lutetjeff/ece395/README.md

Repository for UIUC ECE395 project known as RHipoff. A mixture of the Rhythm Horizon and RE:Flex Dance platforms built from the ground up.
Current configuration is for four load cells only, but firmware supports up to 16 different panels with four load cells each.
