lutetjeff/ece395/exercises/ex4/outputs/3d-back.png

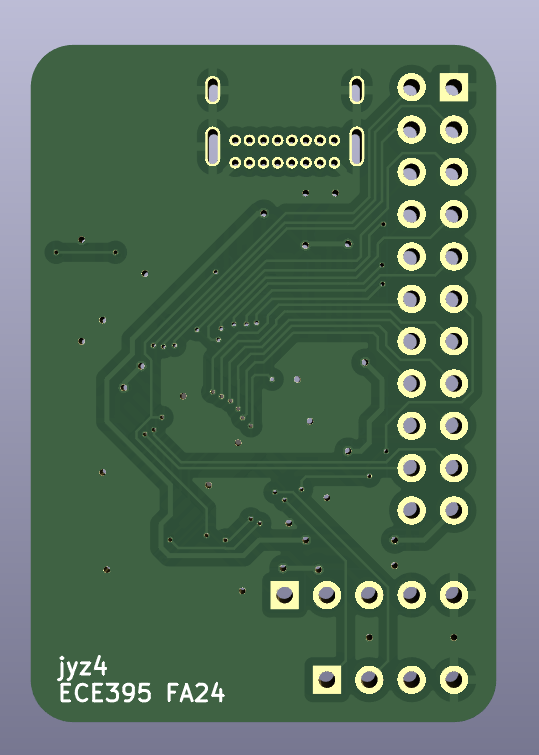
exercises/ex4/outputs/3d-back.png
