lutetjeff/ece395/exercises/ex4/outputs/3d-front.png

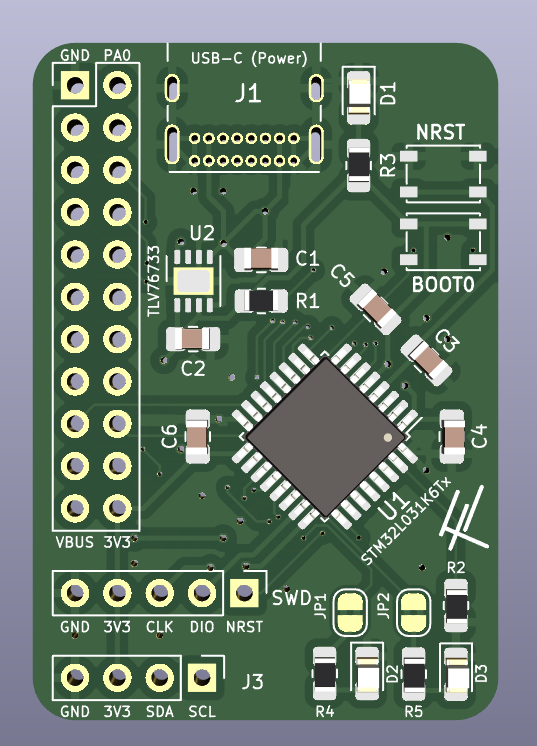
exercises/ex4/outputs/3d-front.png
