lutetjeff/ece395/exercises/ex4/outputs/2024-09-12_16-09.png

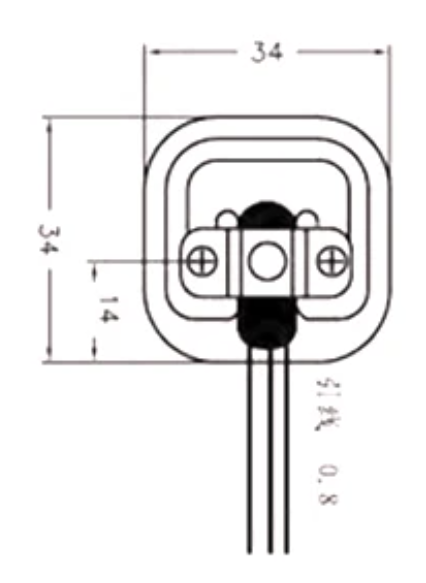
exercises/ex4/outputs/2024-09-12_16-09.png
