lutetjeff/ece395/exercises/ex4/outputs/layout_screenshot.png

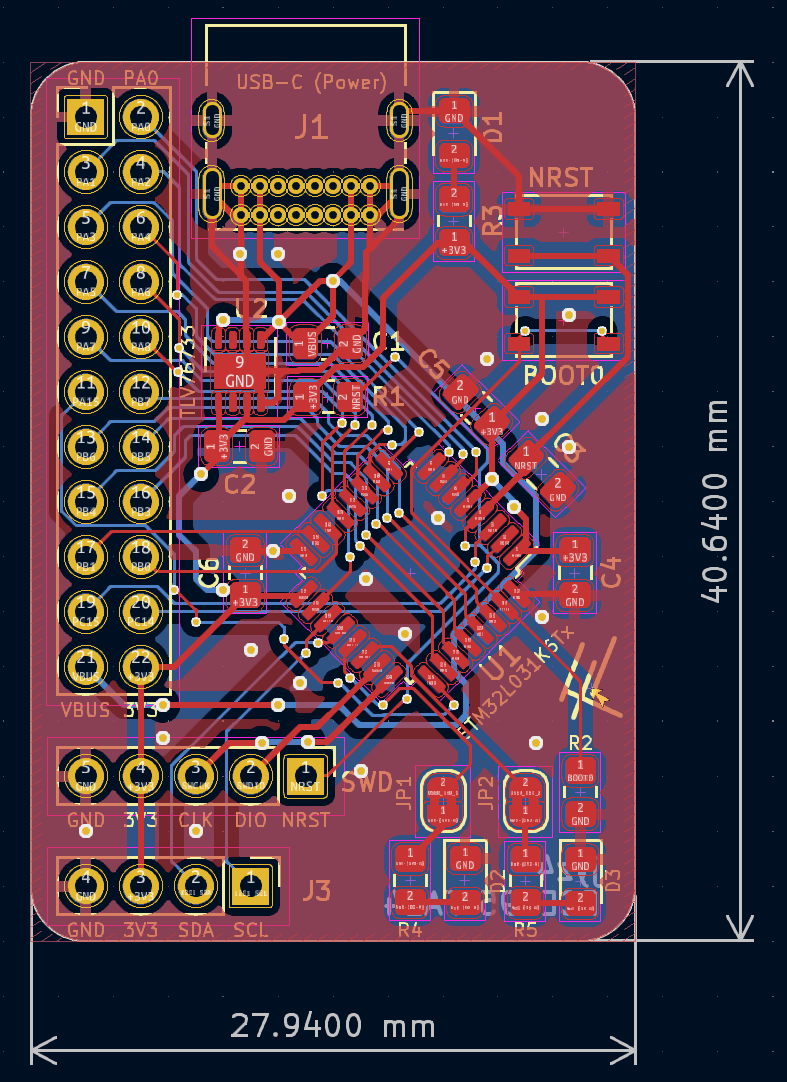
exercises/ex4/outputs/layout_screenshot.png
