lutetjeff/ece395/(list of files, cad)

Other CAD files:
CADFiles/Generic Single Pad Assembly v8.f3z
CADFiles/Load Cell Mount v8.f3z
CADFiles/Plunger v1.f3d
CADFiles/Polycarbonate Top v1.f3d
CADFiles/SparkFun Generic Load Cell v1.f3d
CADFiles/Wooden Base v4.f3d
