lutetjeff/ece395/exercises/ex4/outputs/ex4-F_Silkscreen.pdf

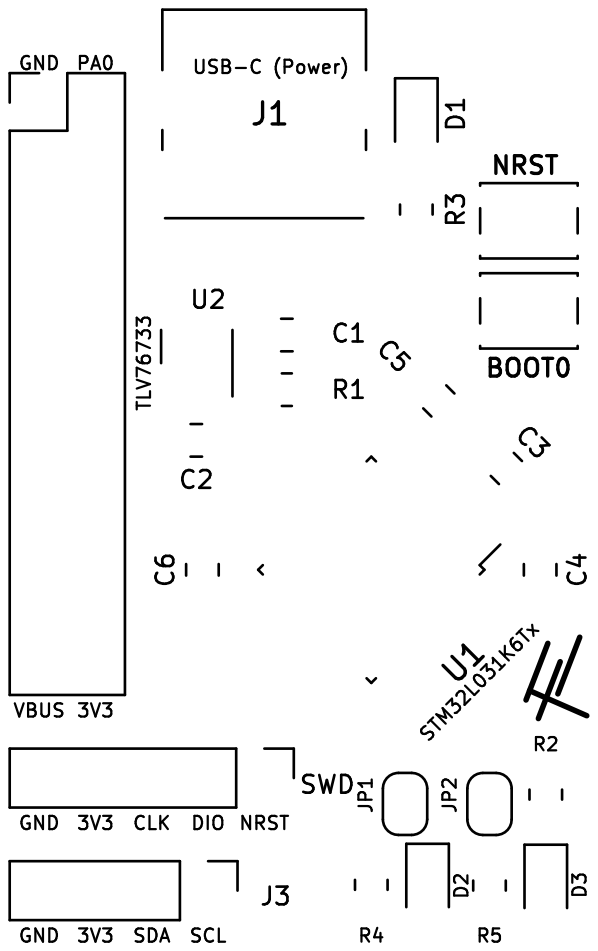
[picture p5: page 1]

GND 3V3 CLK DIO NRST GND 3V3 SDA SCL USB-C (Power) TLV76733
