lutetjeff/ece395/exercises/ex4/outputs/ex4.pdf

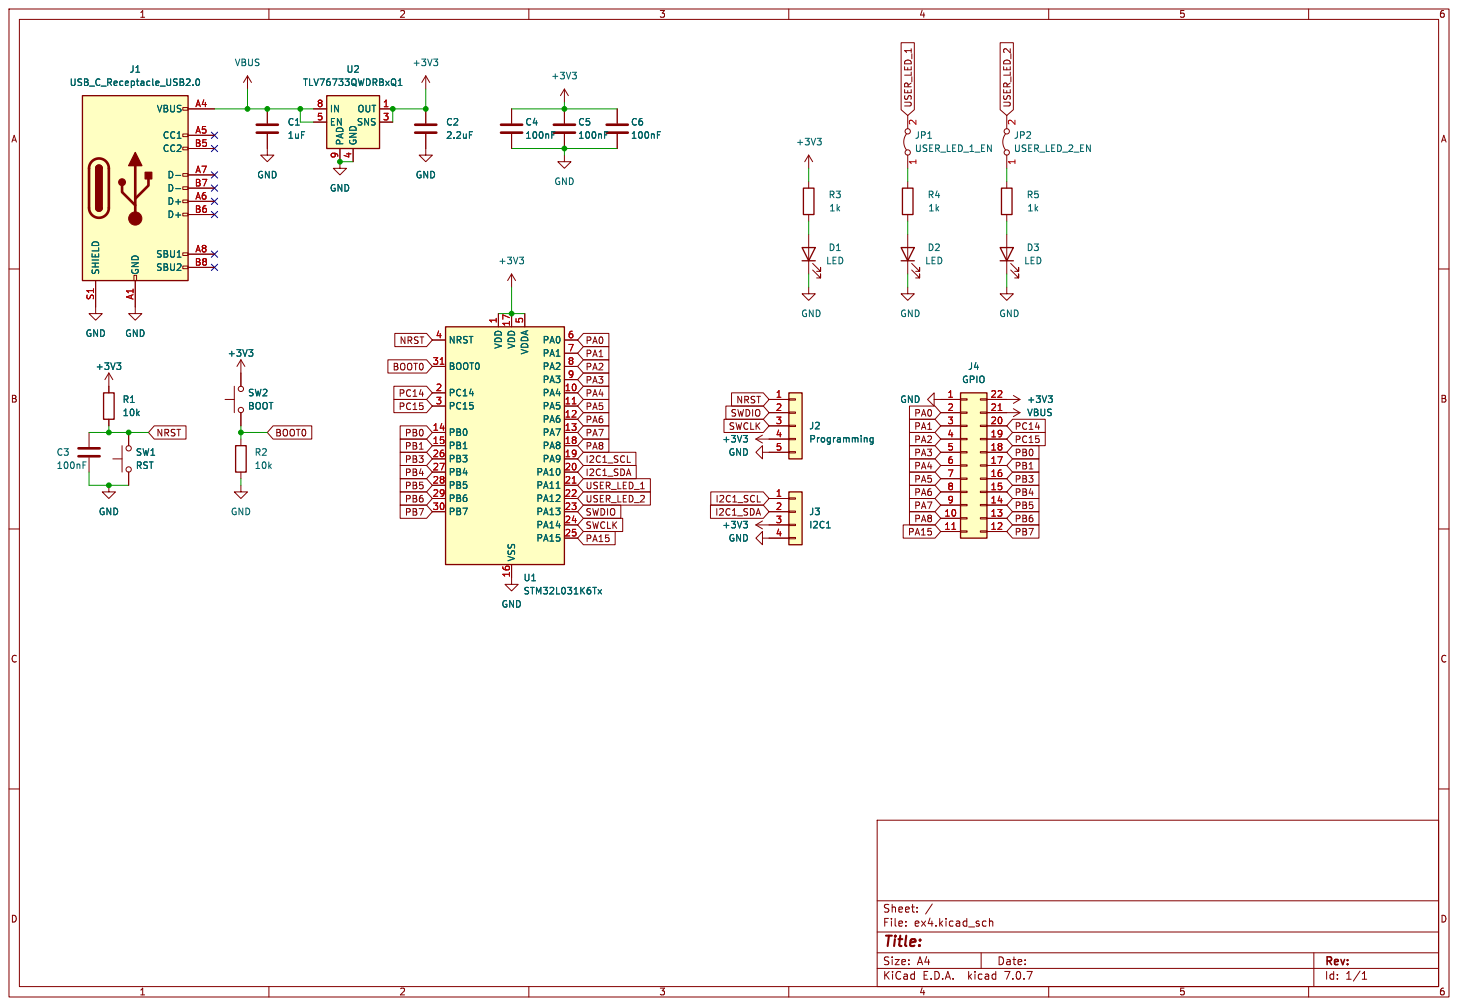
[picture p6: page 1]

1 PA4 10 PA5 11 PA6 12 PA7 13 PB0 14 PB1 15 VSS 16 VDD 17 PA8 18 PA9 19 PC14 2 PA10 20 PA11 21 PA12 22 PA13 23 PA14 24 PA15 25 PB3 26 PB4 27 PB5 28 PB6 29 PC15 3 PB7 30 BOOT0 31 NRST 4 VDDA

5 PA0 6 PA1 7 PA2 8 PA3 9 U1STM32L031K6Tx
Id: 1/1 Title: File: ex4.kicad_sch Sheet: / VDD
