lutetjeff/ece395/CADFiles/MDF Base Drawing v3.pdf

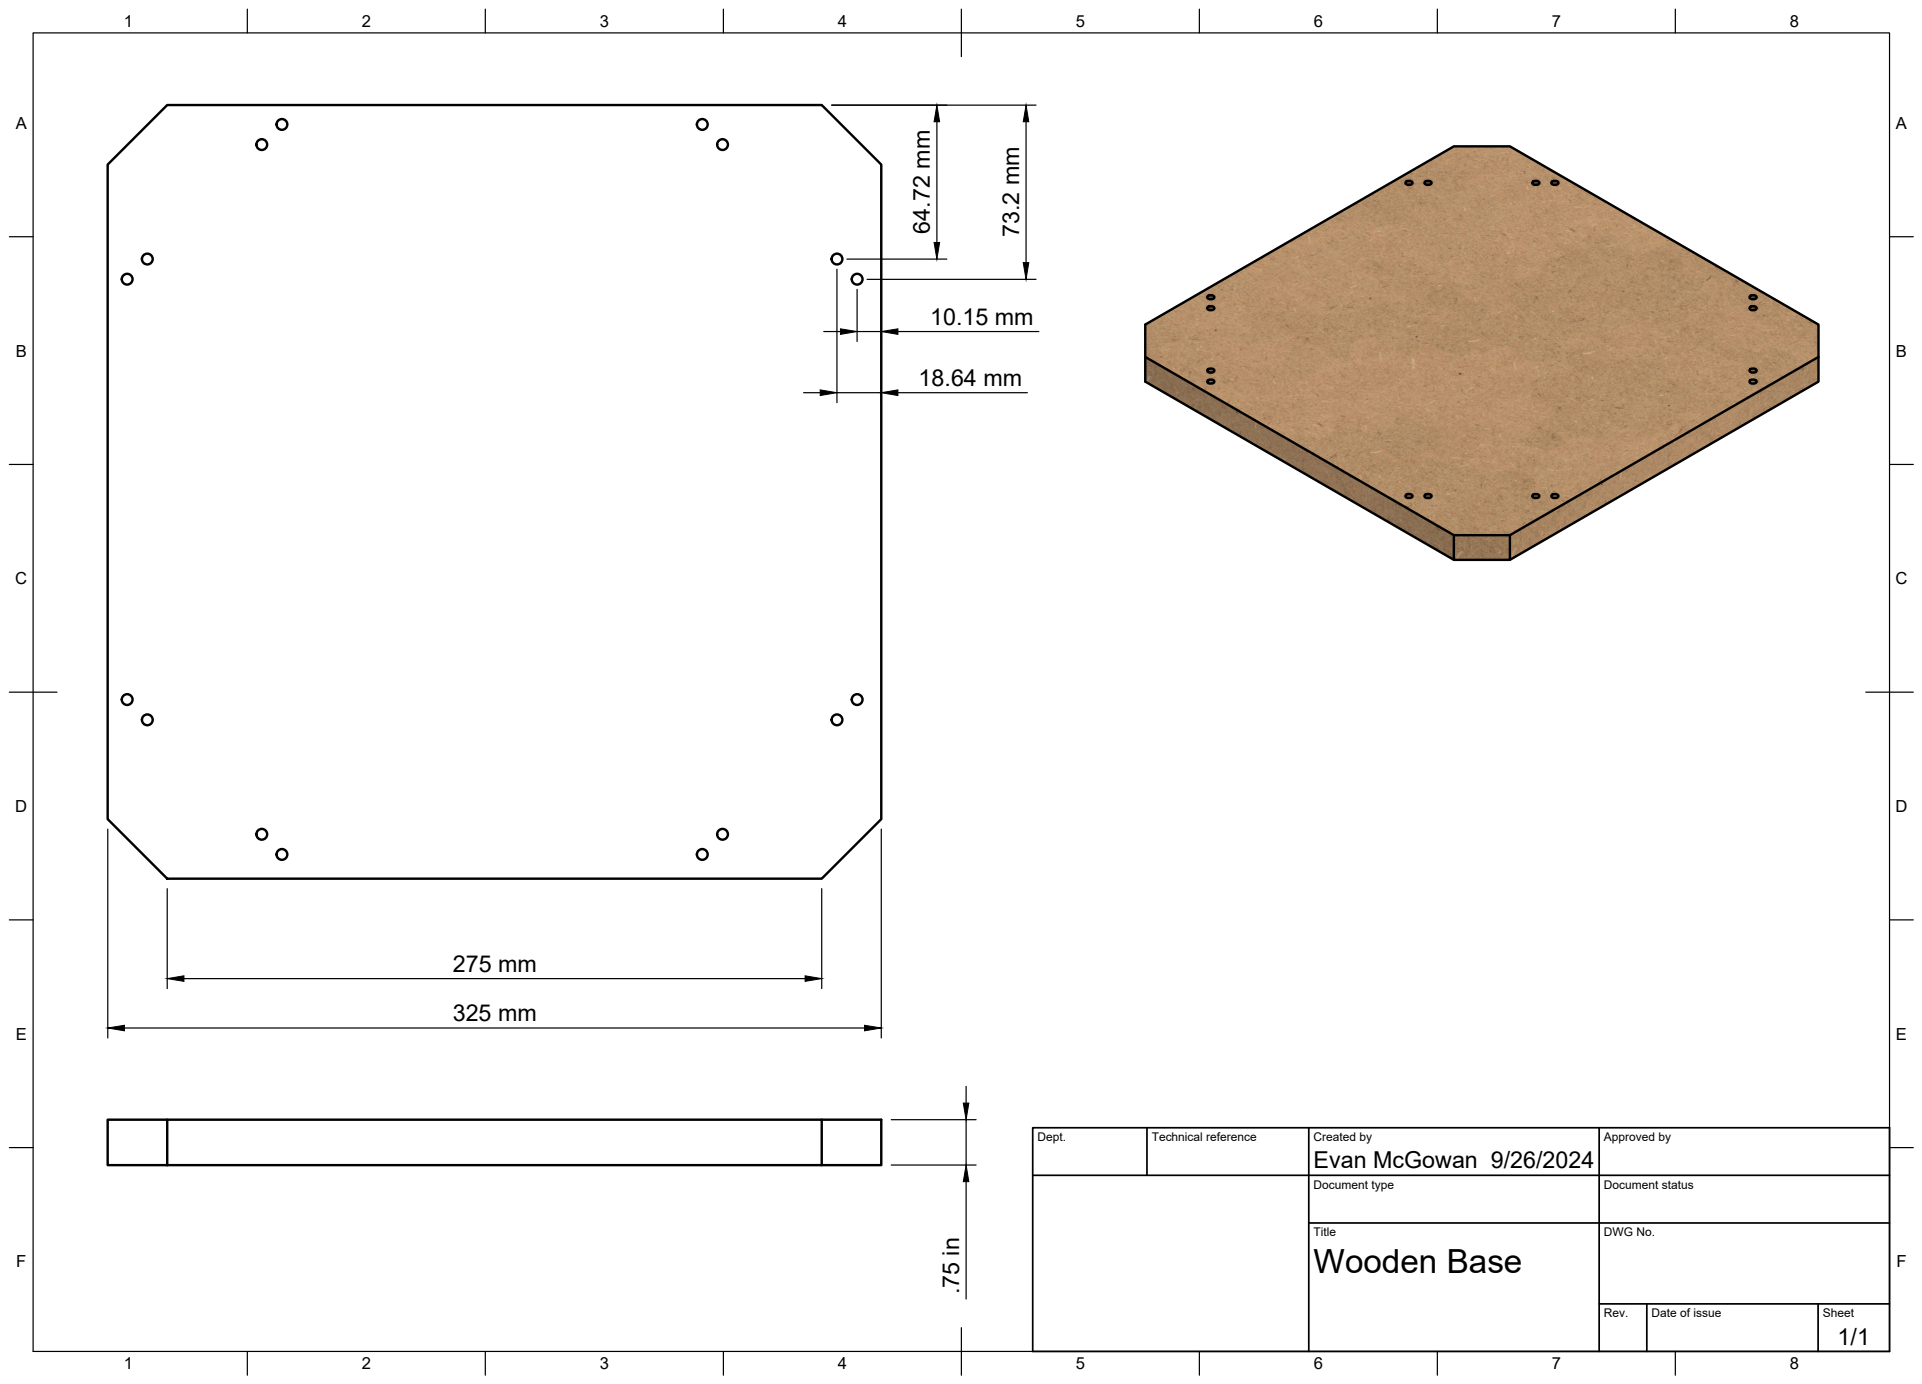
[picture p7: page 1]
Title; DWG No.; Rev.; Date of issue; Sheet; Wooden Base

Dept. | Technical reference | Created by 9/26/2024 | Approved by

Evan McGowan .75 in

Document type | Document status
