lutetjeff/ece395/CADFiles/Plunger Drawing v2.pdf

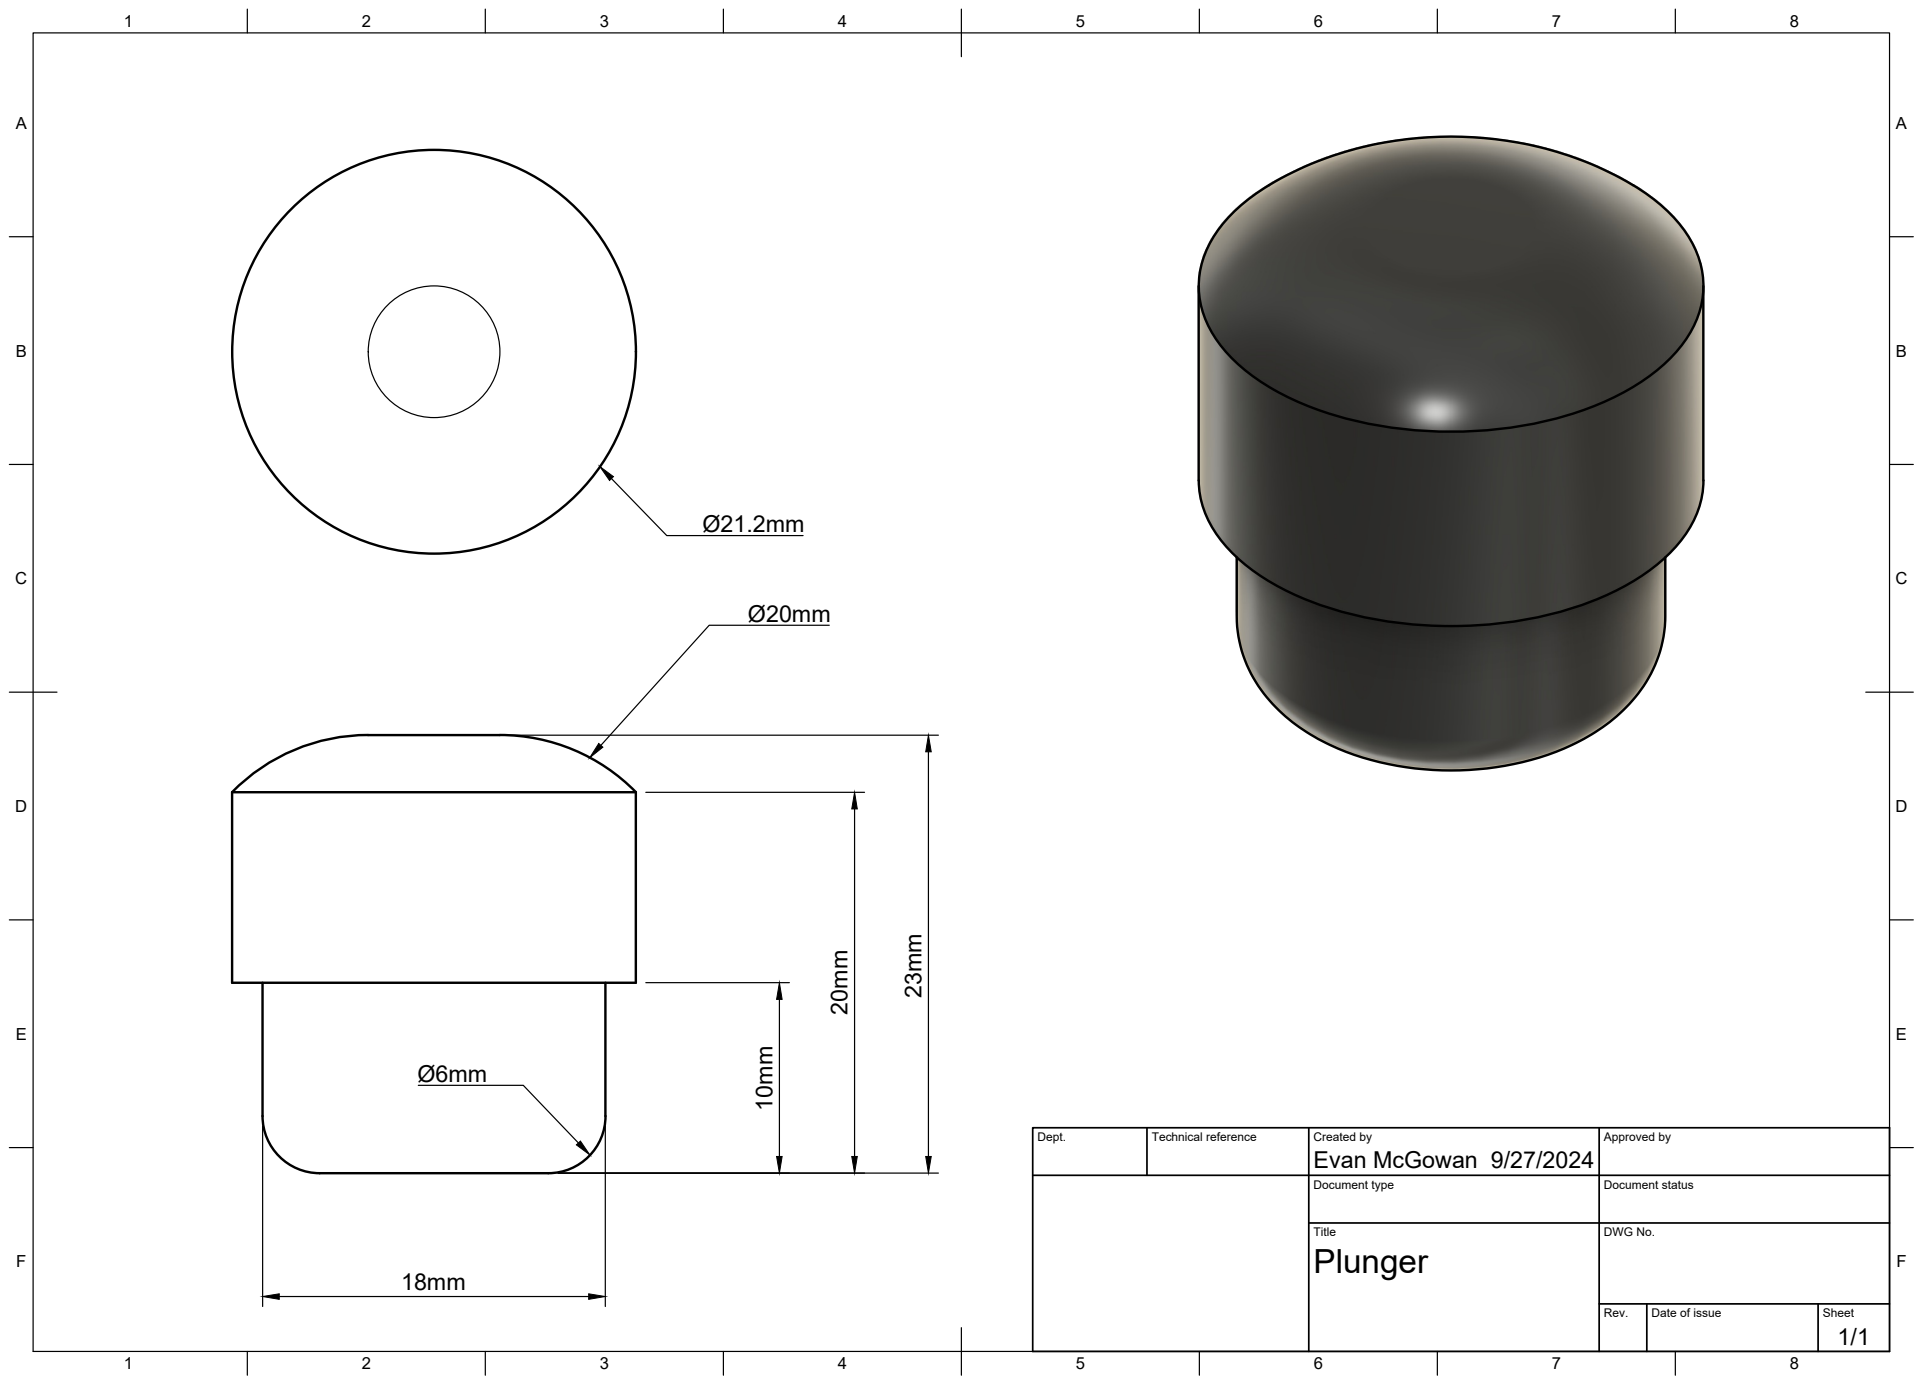
[picture p8: page 1]
Title; DWG No.; Rev.; Date of issue; Sheet

Dept. | Technical reference | Created by Evan McGowan 9/27/2024 | Approved by

Document type | Document status
