lutetjeff/ece395/CADFiles/Polycarbonate Top Drawing v2.pdf

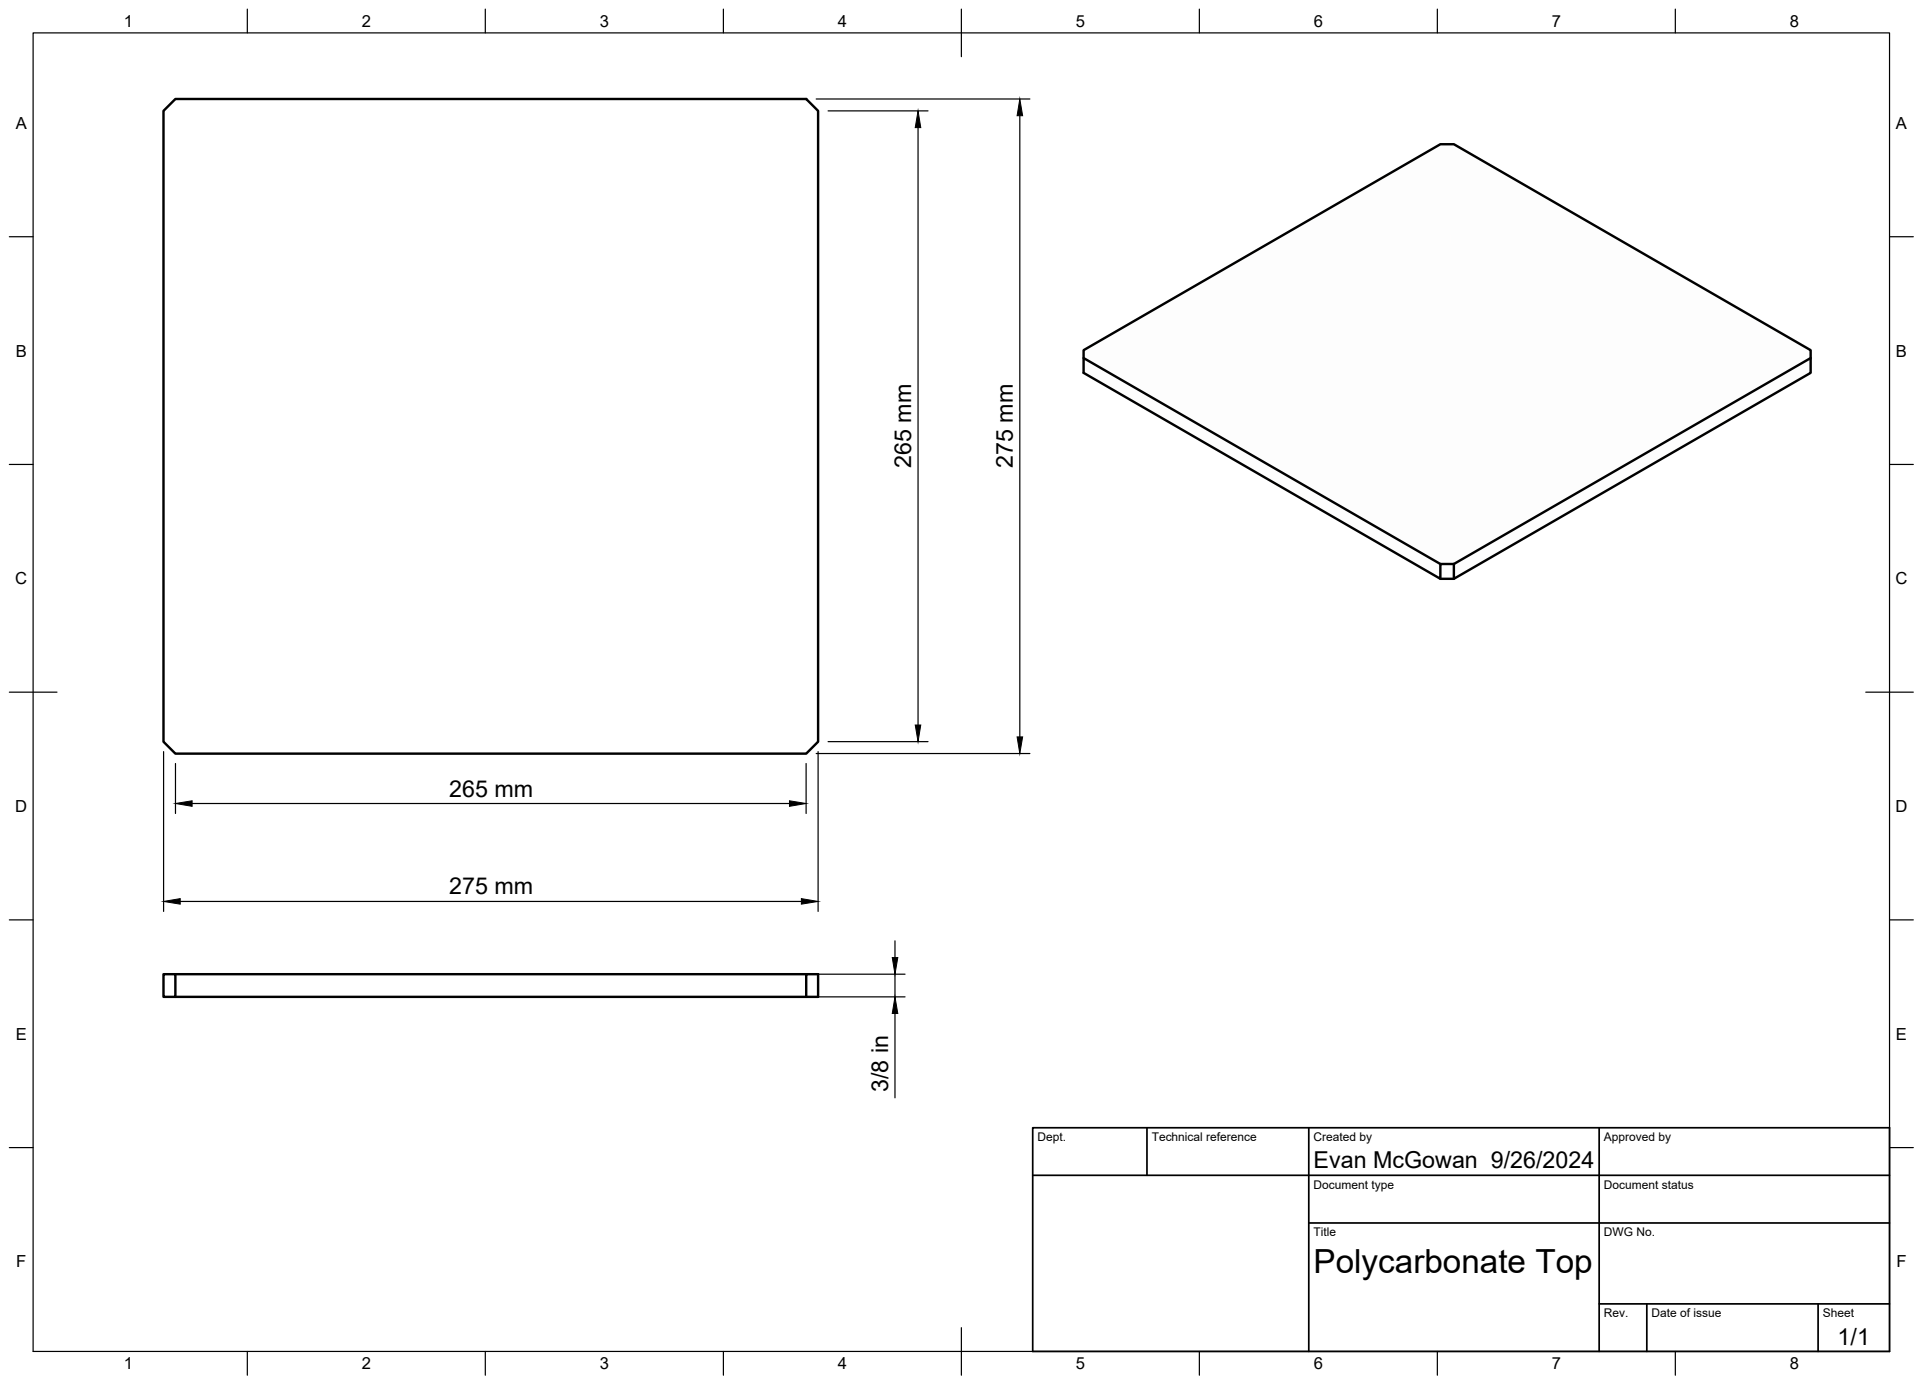
[picture p9: page 1]
Title; DWG No.; Rev.; Date of issue; Sheet; Polycarbonate Top; Evan McGowan 3/8 in

Dept. | Technical reference | Created by 9/26/2024 | Approved by

Document type | Document status
