lutetjeff/ece395/exercises/ex4/outputs/ex4-B_Cu.pdf

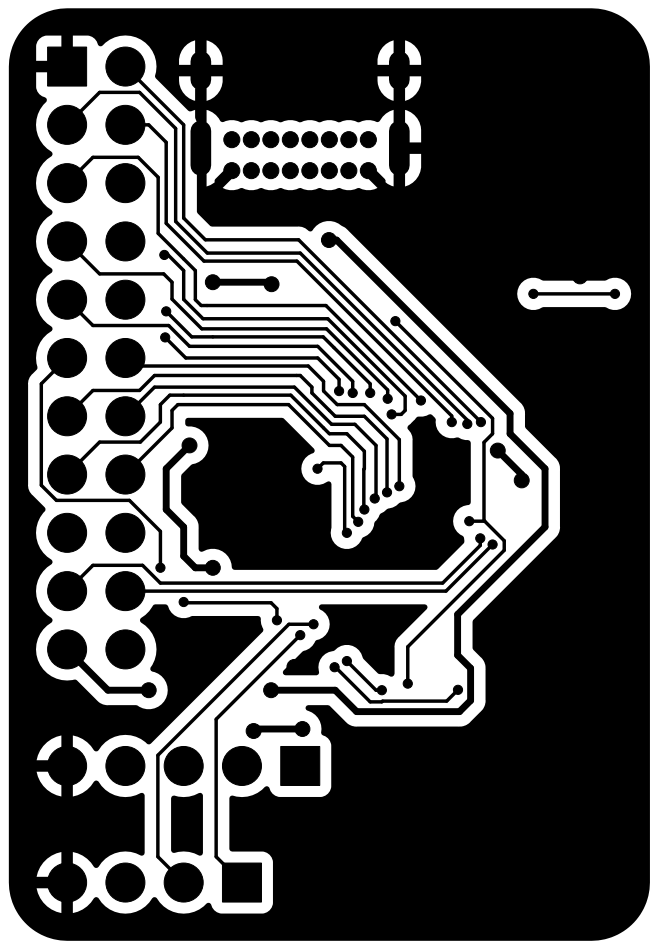
[picture p10: page 1]
