lutetjeff/ece395/exercises/ex4/outputs/ex4-B_Mask.pdf

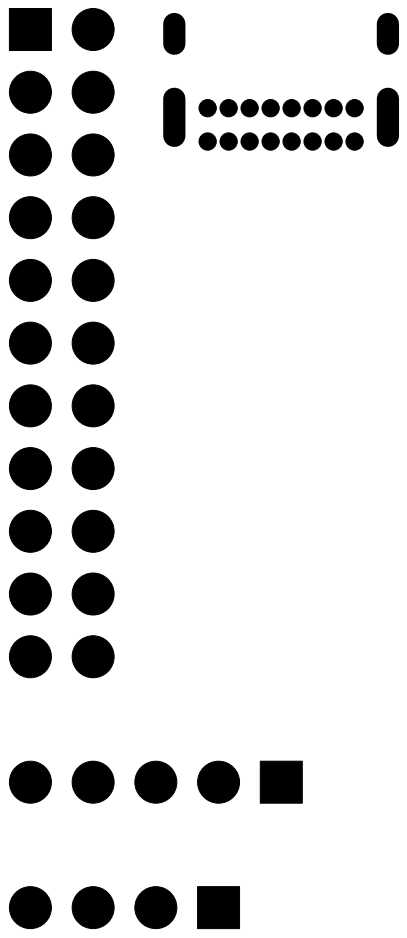
[picture p11: page 1]
