lutetjeff/ece395/exercises/ex4/outputs/ex4-B_Silkscreen.pdf

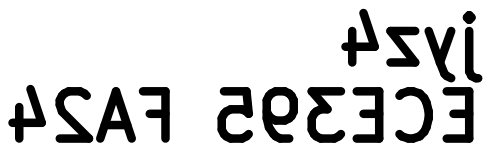
[picture p12: page 1]
