lutetjeff/ece395/exercises/ex4/outputs/ex4-Edge_Cuts.pdf

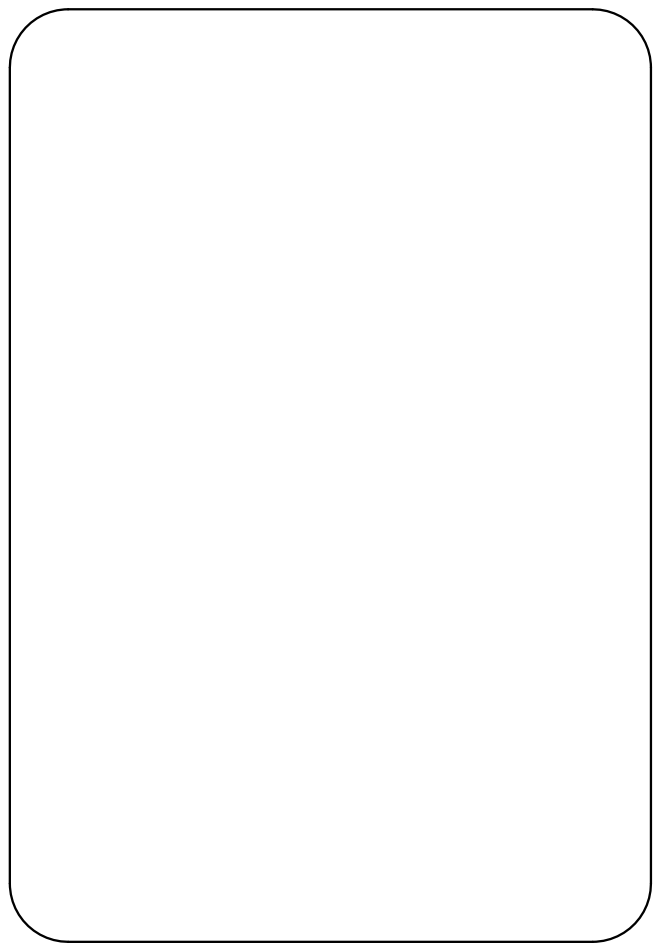
[picture p13: page 1]
