lutetjeff/ece395/exercises/ex4/outputs/ex4-F_Cu.pdf

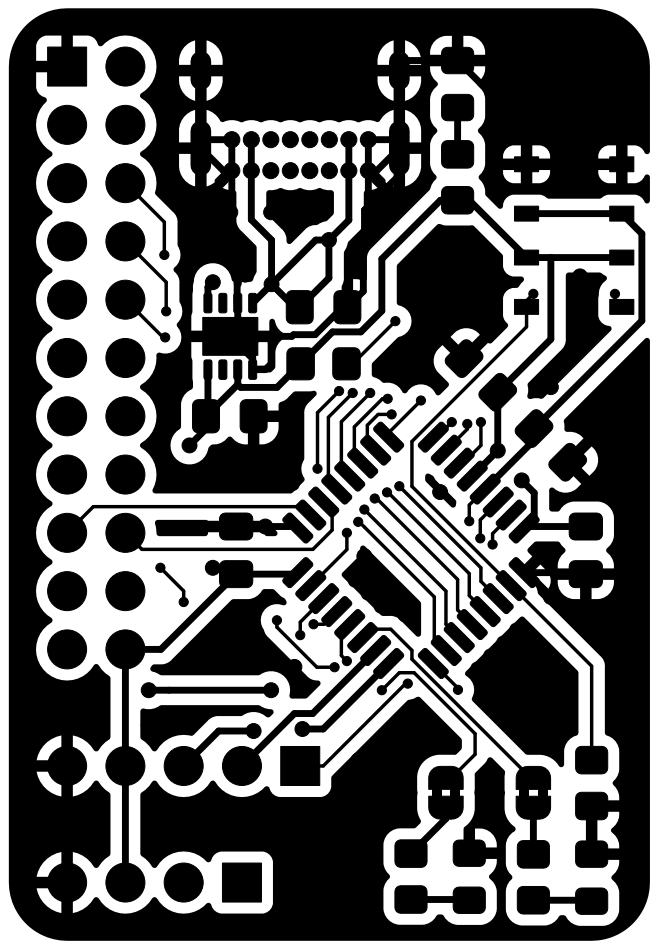
[picture p14: page 1]
