lutetjeff/ece395/exercises/ex4/outputs/ex4-F_Mask.pdf

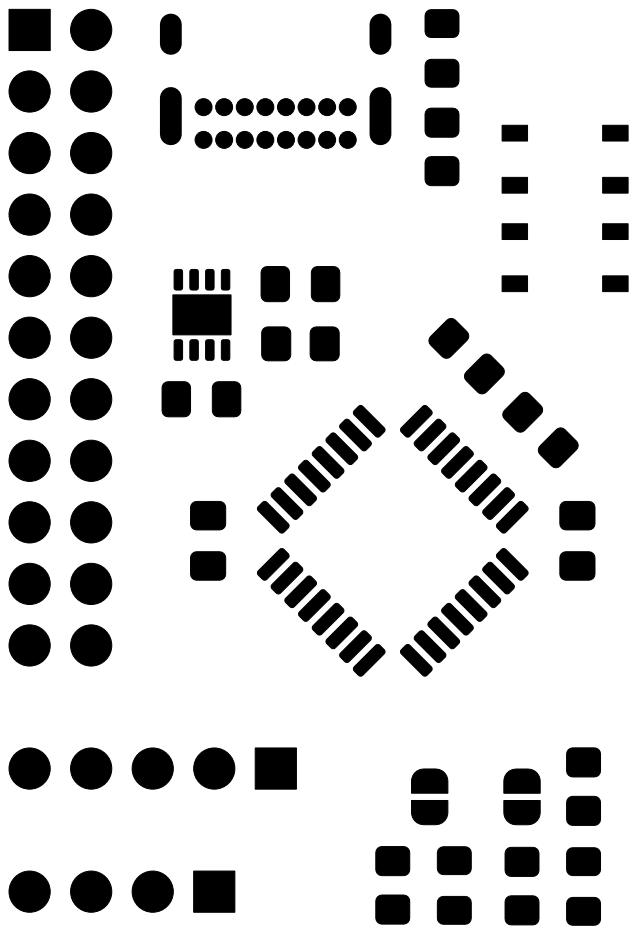
[picture p15: page 1]
