lutetjeff/ece395/exercises/ex4/outputs/ex4-F_Paste.pdf

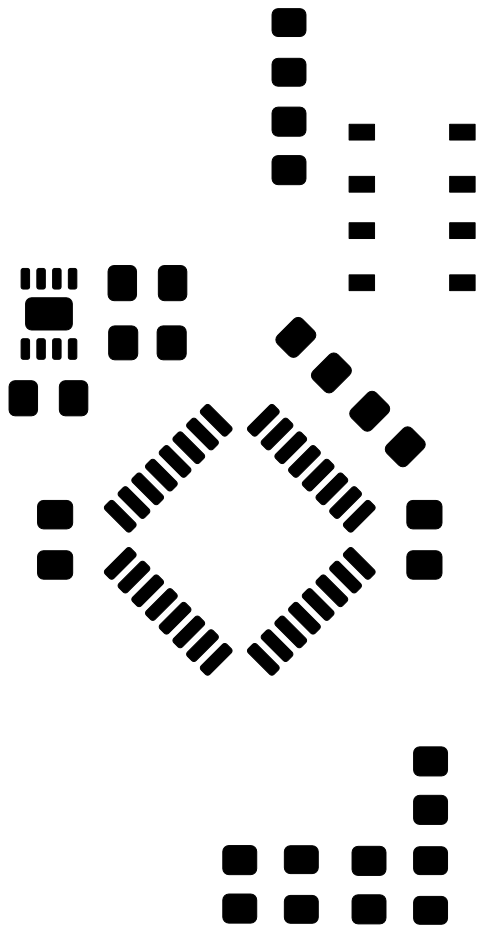
[picture p16: page 1]
