lutetjeff/ece395/395MainBoard/395MainBoard.kicad_pcb

## KiCad design 395MainBoard/395MainBoard.kicad_pcb (2024-12-14)

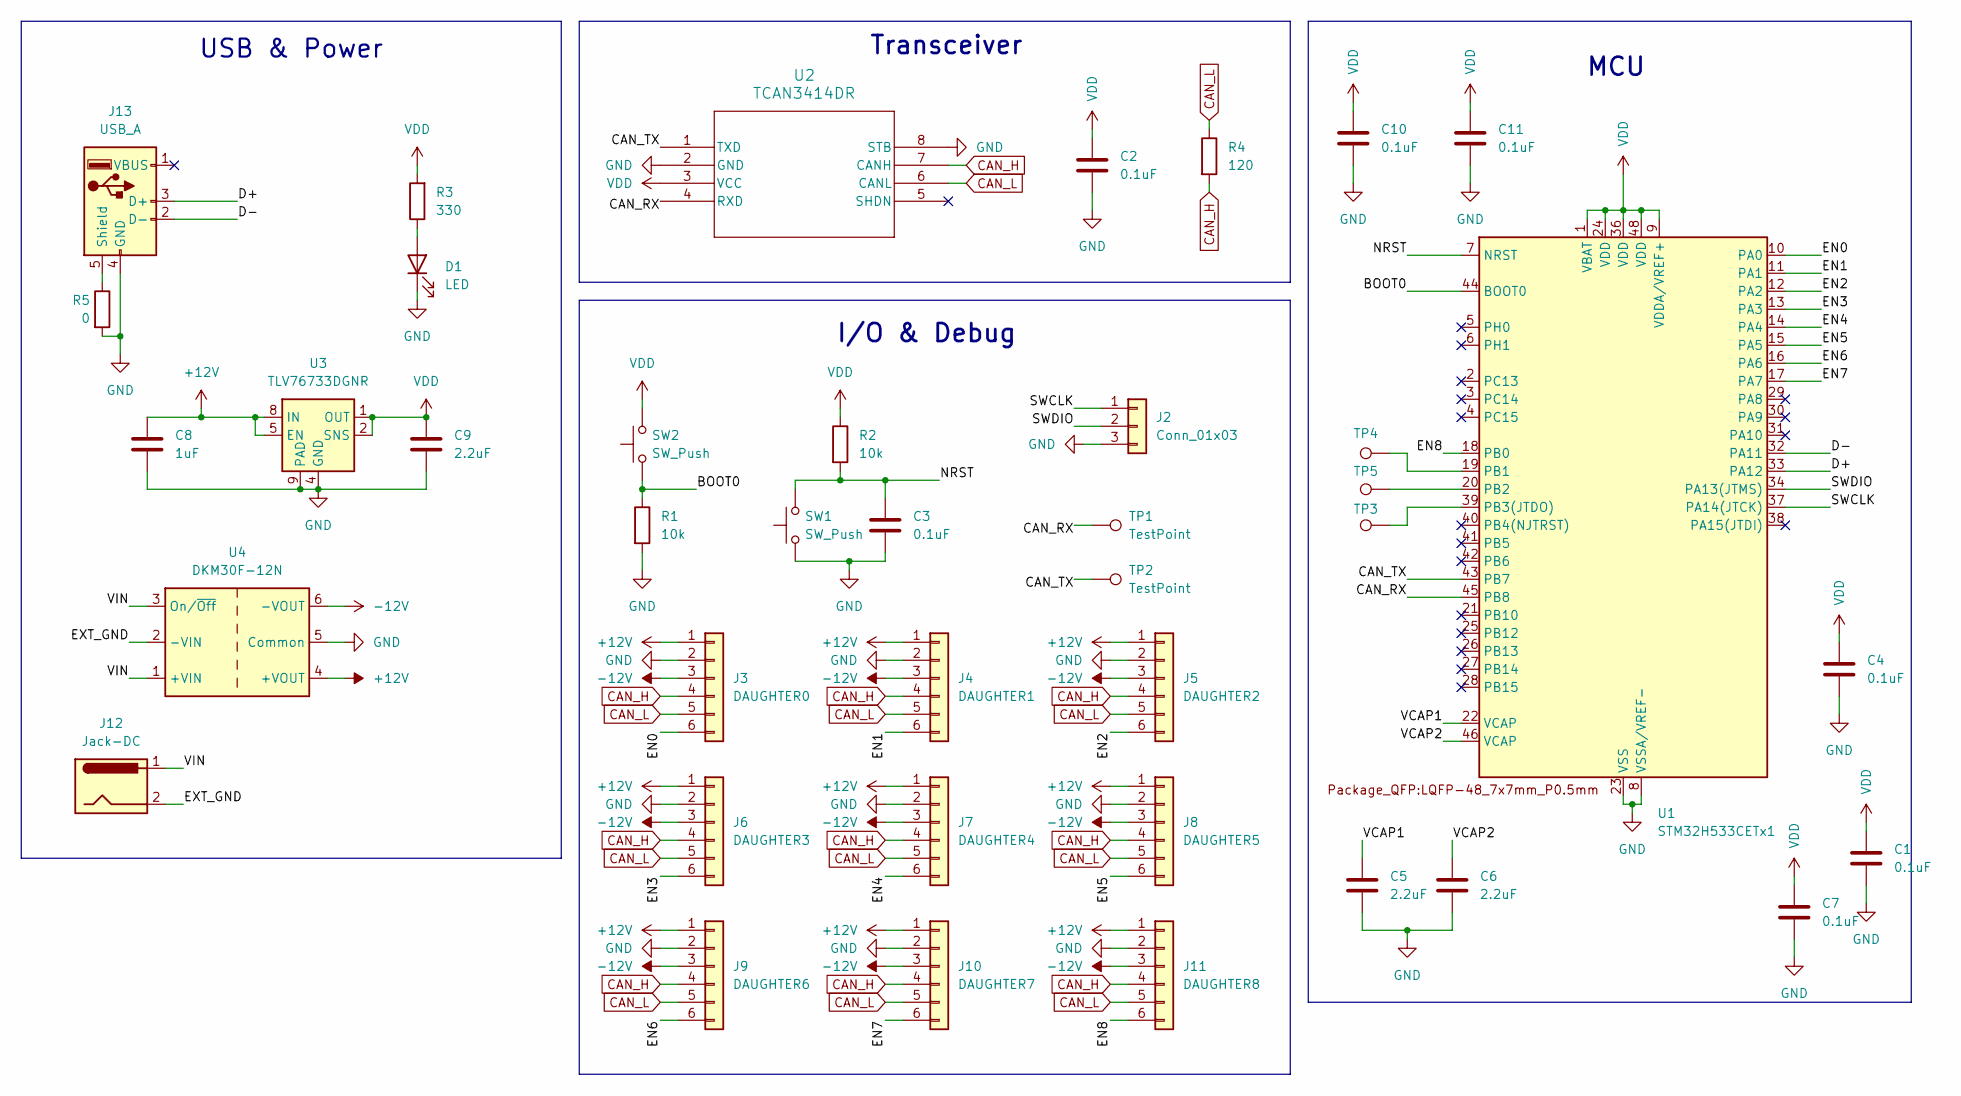
[picture p17: schematic 395MainBoard.kicad_sch]

Parts:
C1, C2, C3, C4, C7, C10, C11: 0.1uF; C_0805_2012Metric_Pad1.18x1.45mm_HandSolder
C5, C6, C9: 2.2uF; C_0805_2012Metric_Pad1.18x1.45mm_HandSolder
C8: 1uF; C_0805_2012Metric_Pad1.18x1.45mm_HandSolder
D1: LED; LED_0805_2012Metric_Pad1.15x1.40mm_HandSolder
J2: Conn_01x03; JST_XH_B3B-XH-A_1x03_P2.50mm_Vertical
J3: DAUGHTER0; JST_XH_B6B-XH-A_1x06_P2.50mm_Vertical
J4: DAUGHTER1; JST_XH_B6B-XH-A_1x06_P2.50mm_Vertical
J5: DAUGHTER2; JST_XH_B6B-XH-A_1x06_P2.50mm_Vertical
J6: DAUGHTER3; JST_XH_B6B-XH-A_1x06_P2.50mm_Vertical
J7: DAUGHTER4; JST_XH_B6B-XH-A_1x06_P2.50mm_Vertical
J8: DAUGHTER5; JST_XH_B6B-XH-A_1x06_P2.50mm_Vertical
J9: DAUGHTER6; JST_XH_B6B-XH-A_1x06_P2.50mm_Vertical
J10: DAUGHTER7; JST_XH_B6B-XH-A_1x06_P2.50mm_Vertical
J11: DAUGHTER8; JST_XH_B6B-XH-A_1x06_P2.50mm_Vertical
J12: Jack-DC; BarrelJack_Horizontal
J13: USB_A; USB_A_Molex_67643_Horizontal
R1, R2: 10k; R_0805_2012Metric_Pad1.20x1.40mm_HandSolder
R3: 330; R_0805_2012Metric_Pad1.20x1.40mm_HandSolder
R4: 120; R_0805_2012Metric_Pad1.20x1.40mm_HandSolder
R5: 0; R_0805_2012Metric_Pad1.20x1.40mm_HandSolder
SW1, SW2: SW_Push; SW_PUSH_6mm
TP1, TP2, TP3, TP4, TP5: TestPoint; TestPoint_Pad_D2.0mm
U1: STM32H533CETx1; LQFP-48_7x7mm_P0.5mm
U2: TCAN3414DR; SOIC-8_3.9x4.9mm_P1.27mm
U3: TLV76733DGNR; VSSOP-8_3x3mm_P0.65mm
U4: DKM30F-12N

Connections:
+12V: C8.1, J3.1, J4.1, J5.1, J6.1, J7.1, J8.1, J9.1, J10.1, J11.1, U3.5 (EN), U3.8 (IN), U4.4 (+VOUT)
-12V: J3.3, J4.3, J5.3, J6.3, J7.3, J8.3, J9.3, J10.3, J11.3, U4.6 (-VOUT)
/BOOT0: R1.1, SW2.1, U1.44 (BOOT0)
/CAN_RX: TP1.1, U1.45 (PB8), U2.4 (RXD)
/CAN_TX: TP2.1, U1.43 (PB7), U2.1 (TXD)
/D+: J13.3 (D+), U1.33 (PA12)
/D-: J13.2 (D-), U1.32 (PA11)
/EN0: J3.6, U1.10 (PA0)
/EN1: J4.6, U1.11 (PA1)
/EN2: J5.6, U1.12 (PA2)
/EN3: J6.6, U1.13 (PA3)
/EN4: J7.6, U1.14 (PA4)
/EN5: J8.6, U1.15 (PA5)
/EN6: J9.6, U1.16 (PA6)
/EN7: J10.6, U1.17 (PA7)
/EN8: J11.6, U1.18 (PB0)
/EXT_GND: J12.2, U4.2 (-VIN)
/NRST: C3.1, R2.2, SW1.2, U1.7 (NRST)
/SWCLK: J2.1, U1.37 (PA14(JTCK))
/SWDIO: J2.2, U1.34 (PA13(JTMS))
/VCAP1: C5.1, U1.22 (VCAP)
/VCAP2: C6.1, U1.46 (VCAP)
/VIN: J12.1, U4.1 (+VIN), U4.3 (On/~Off)
CAN_H: J3.4, J4.4, J5.4, J6.4, J7.4, J8.4, J9.4, J10.4, J11.4, R4.2, U2.7 (CANH)
CAN_L: J3.5, J4.5, J5.5, J6.5, J7.5, J8.5, J9.5, J10.5, J11.5, R4.1, U2.6 (CANL)
GND: C1.2, C2.2, C3.2, C4.2, C5.2, C6.2, C7.2, C8.2, C9.2, C10.2, C11.2, D1.1 (K), J2.3, J3.2, J4.2, J5.2, J6.2, J7.2, J8.2, J9.2, J10.2, J11.2, J13.4 (GND), R1.2, R5.2, SW1.1, U1.8 (VSSA/VREF-), U1.23 (VSS), U1.35 (VSS), U1.47 (VSS), U2.2 (GND), U2.8 (STB), U3.4 (GND), U3.6 (GND), U3.9 (PAD), U4.5 (Common)
unnamed: D1.2 (A), R3.1
unnamed: J13.5 (Shield), R5.1
unnamed: TP4.1, U1.19 (PB1)
unnamed: TP5.1, U1.20 (PB2)
unnamed: TP3.1, U1.39 (PB3(JTDO))
VDD: C1.1, C2.1, C4.1, C7.1, C9.1, C10.1, C11.1, R2.1, R3.2, SW2.2, U1.1 (VBAT), U1.9 (VDDA/VREF+), U1.24 (VDD), U1.36 (VDD), U1.48 (VDD), U2.3 (VCC), U3.1 (OUT), U3.2 (SNS)

Notes on the sheet:
I/O & Debug
USB & Power
Transceiver
MCU

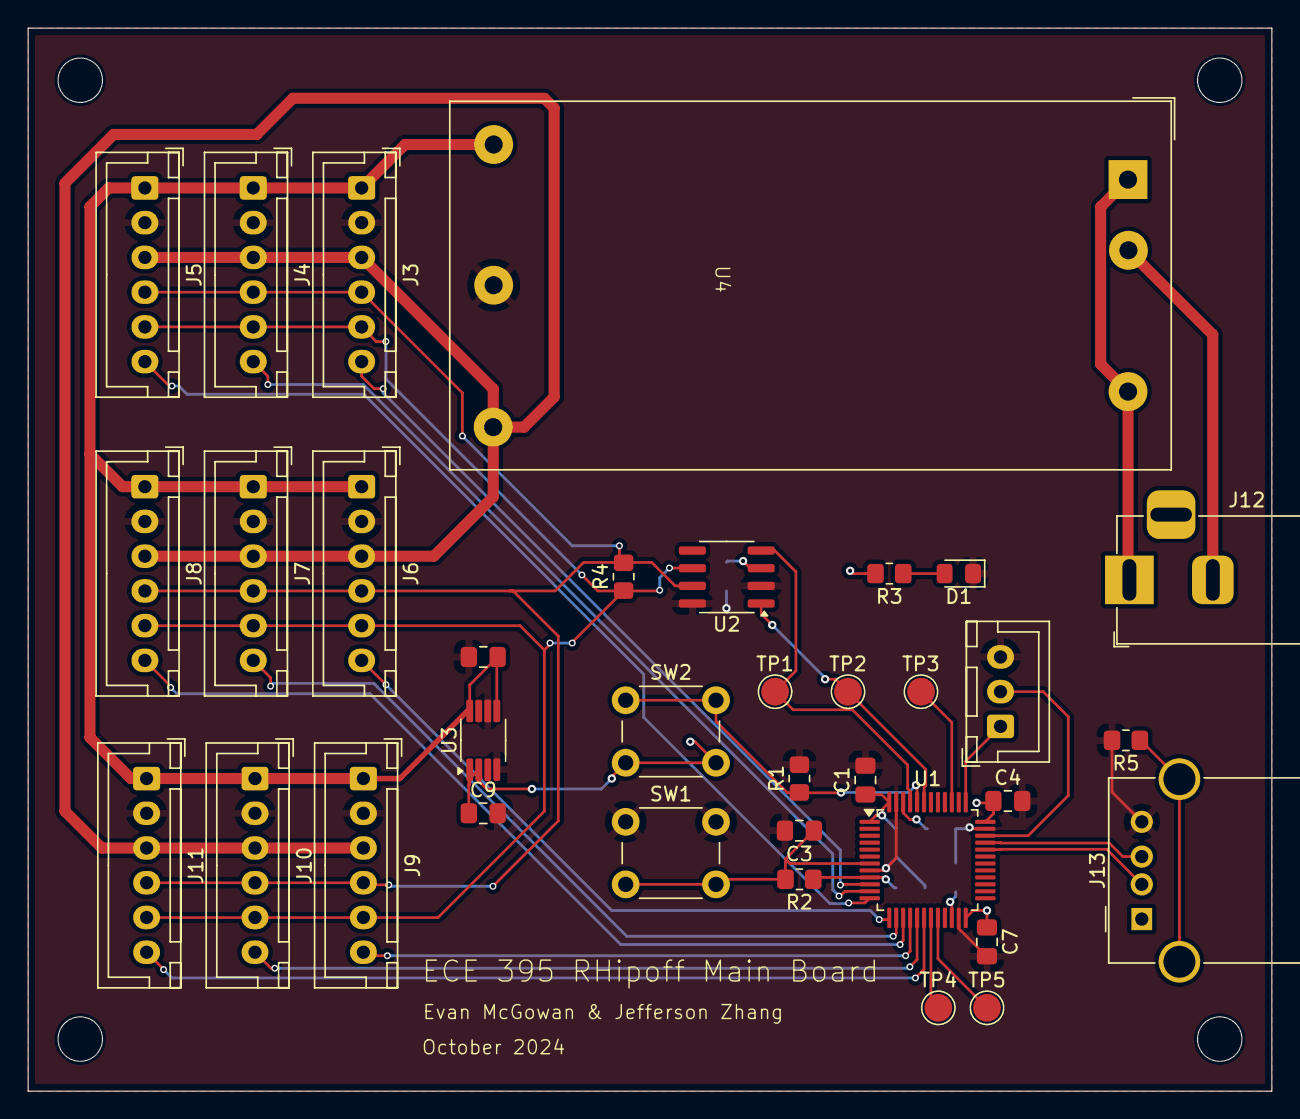
[picture p18: board 395MainBoard.kicad_pcb from above]

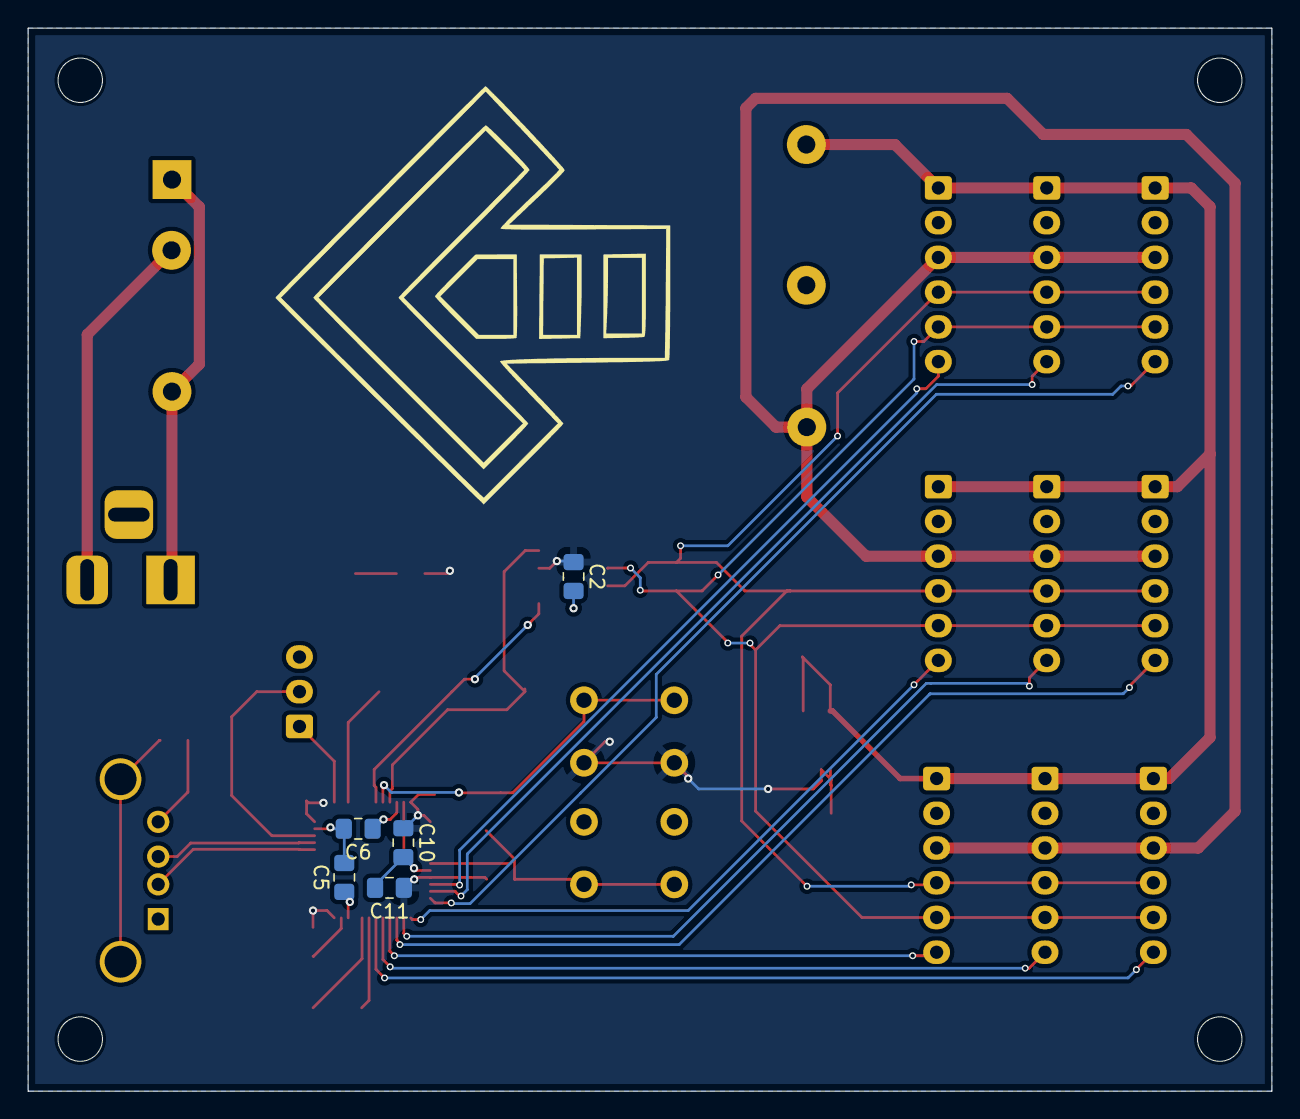
[picture p19: board 395MainBoard.kicad_pcb from below]

Board: 2 copper layers, 89.5 x 76.5 mm, 40 parts (5 on the bottom side), 32 nets.
