lutetjeff/ece395/corner-board/corner-board-wson6.kicad_pcb

## KiCad design corner-board/corner-board-wson6.kicad_pcb (2024-10-22)

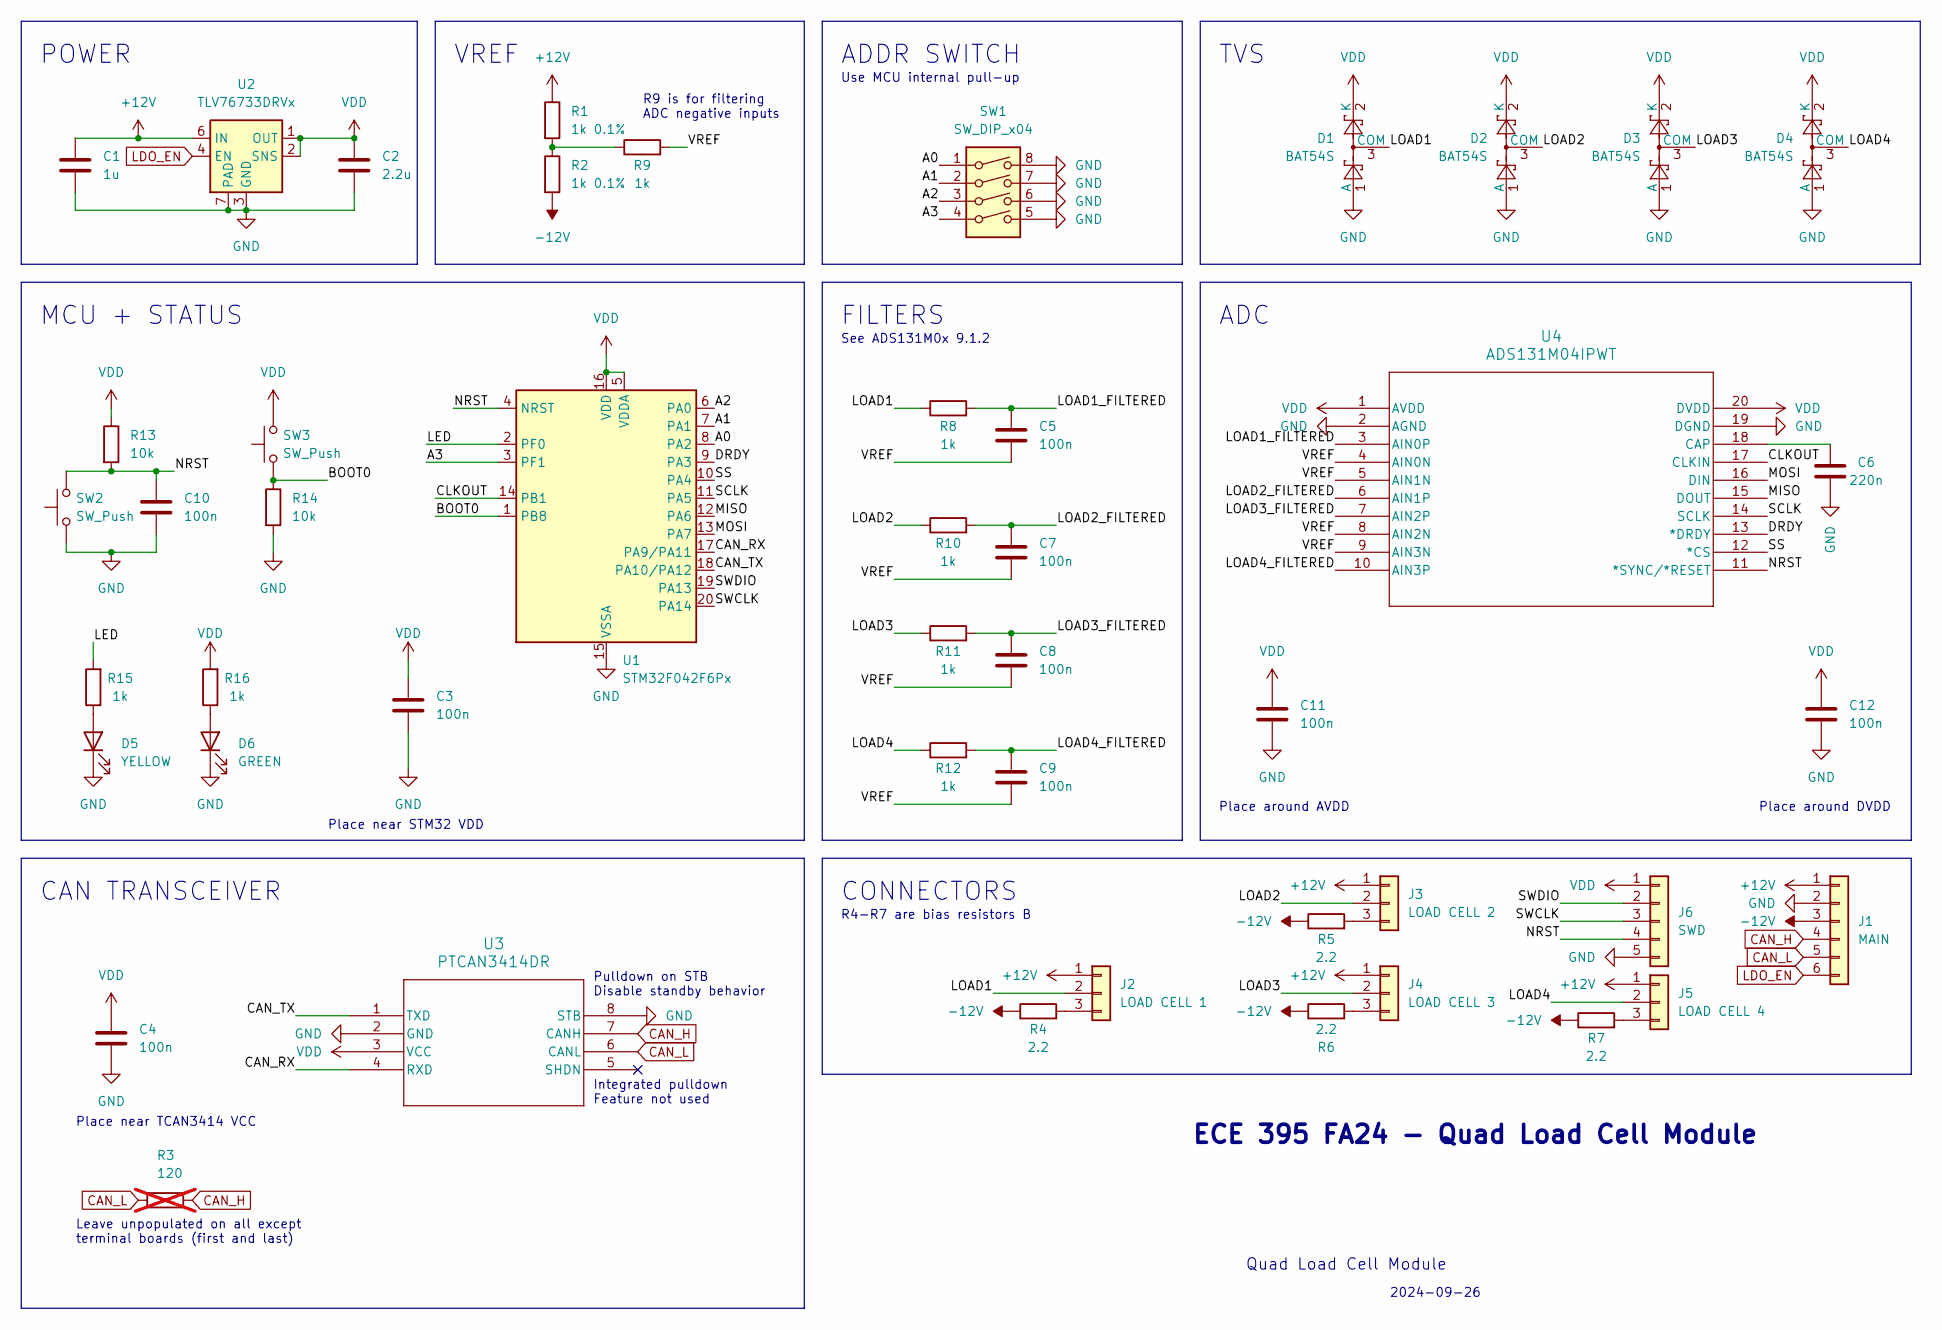
[picture p20: schematic corner-board-wson6.kicad_sch]

Parts:
C1: 1u; C_0805_2012Metric_Pad1.18x1.45mm_HandSolder; LCSC Part # C77386
C2: 2.2u; C_0805_2012Metric_Pad1.18x1.45mm_HandSolder; LCSC Part # C99227
C3, C4, C5, C7, C8, C9, C10, C11, C12: 100n; C_0603_1608Metric_Pad1.08x0.95mm_HandSolder; LCSC Part # C14663
C6: 220n; C_0805_2012Metric_Pad1.18x1.45mm_HandSolder; LCSC C77051
D1, D2, D3, D4: BAT54S; SOT-23; LCSC Part # C916425
D5: YELLOW; LED_0805_2012Metric_Pad1.15x1.40mm_HandSolder; LCSC Part # C2296
D6: GREEN; LED_0805_2012Metric_Pad1.15x1.40mm_HandSolder; LCSC Part # C2297
J1: MAIN; JST_XH_S6B-XH-A_1x06_P2.50mm_Horizontal
J2: LOAD CELL 1; JST_XH_S3B-XH-A_1x03_P2.50mm_Horizontal
J3: LOAD CELL 2; JST_XH_S3B-XH-A_1x03_P2.50mm_Horizontal
J4: LOAD CELL 3; JST_XH_S3B-XH-A_1x03_P2.50mm_Horizontal
J5: LOAD CELL 4; JST_XH_S3B-XH-A_1x03_P2.50mm_Horizontal
J6: SWD; PinHeader_1x05_P2.54mm_Vertical
R1, R2: 1k 0.1%; R_0603_1608Metric_Pad0.98x0.95mm_HandSolder; LCSC Part # C110776
R3: 120; R_0603_1608Metric_Pad0.98x0.95mm_HandSolder; not fitted
R4, R5, R6, R7: 2.2; R_0603_1608Metric_Pad0.98x0.95mm_HandSolder; LCSC Part # C25226
R8, R9, R10, R11, R12, R15, R16: 1k; R_0603_1608Metric_Pad0.98x0.95mm_HandSolder; LCSC Part # C21190
R13, R14: 10k; R_0603_1608Metric_Pad0.98x0.95mm_HandSolder; LCSC Part # C25804
SW1: SW_DIP_x04; SW_DIP_SPSTx04_Slide_6.7x11.72mm_W7.62mm_P2.54mm_LowProfile
SW2, SW3: SW_Push; SW_PUSH_6mm
U1: STM32F042F6Px; TSSOP-20_4.4x6.5mm_P0.65mm; LCSC Part # C81000
U2: TLV76733DRVx; WSON-6-1EP_2x2mm_P0.65mm_EP1x1.6mm_ThermalVias; LCSC Part # C2848334
U3: PTCAN3414DR; SOIC8_D_TEX; LCSC Part # C189939
U4: ADS131M04IPWT; PW20_TEX; LCSC Part # C2862562

Connections:
+12V: C1.1, J1.1, J2.1, J3.1, J4.1, J5.1, R1.1, U2.6 (IN)
-12V: J1.3, R2.2, R4.1, R5.1, R6.1, R7.1
/A0: SW1.1, U1.8 (PA2)
/A1: SW1.2, U1.7 (PA1)
/A2: SW1.3, U1.6 (PA0)
/A3: SW1.4, U1.3 (PF1)
/BOOT0: R14.1, SW3.1, U1.1 (PB8)
/CAN_RX: U1.17 (PA9/PA11), U3.4 (RXD)
/CAN_TX: U1.18 (PA10/PA12), U3.1 (TXD)
/CLKOUT: U1.14 (PB1), U4.17 (CLKIN)
/DRDY: U1.9 (PA3), U4.13 (*DRDY)
/LED: R15.2, U1.2 (PF0)
/LOAD1: D1.3 (COM), J2.2, R8.1
/LOAD1_FILTERED: C5.1, R8.2, U4.3 (AIN0P)
/LOAD2: D2.3 (COM), J3.2, R10.1
/LOAD2_FILTERED: C7.1, R10.2, U4.6 (AIN1P)
/LOAD3: D3.3 (COM), J4.2, R11.1
/LOAD3_FILTERED: C8.1, R11.2, U4.7 (AIN2P)
/LOAD4: D4.3 (COM), J5.2, R12.1
/LOAD4_FILTERED: C9.1, R12.2, U4.10 (AIN3P)
/MISO: U1.12 (PA6), U4.15 (DOUT)
/MOSI: U1.13 (PA7), U4.16 (DIN)
/NRST: C10.1, J6.4, R13.2, SW2.2, U1.4 (NRST), U4.11 (*SYNC/*RESET)
/SCLK: U1.11 (PA5), U4.14 (SCLK)
/SS: U1.10 (PA4), U4.12 (*CS)
/SWCLK: J6.3, U1.20 (PA14)
/SWDIO: J6.2, U1.19 (PA13)
/VREF: C5.2, C7.2, C8.2, C9.2, R9.2, U4.4 (AIN0N), U4.5 (AIN1N), U4.8 (AIN2N), U4.9 (AIN3N)
CAN_H: J1.4, R3.1, U3.7 (CANH)
CAN_L: J1.5, R3.2, U3.6 (CANL)
GND: C1.2, C2.2, C3.2, C4.2, C6.2, C10.2, C11.2, C12.2, D1.1 (A), D2.1 (A), D3.1 (A), D4.1 (A), D5.1 (K), D6.1 (K), J1.2, J6.5, R14.2, SW1.5, SW1.6, SW1.7, SW1.8, SW2.1, U1.15 (VSSA), U2.3 (GND), U2.5 (GND), U2.7 (PAD), U3.2 (GND), U3.8 (STB), U4.2 (AGND), U4.19 (DGND)
LDO_EN: J1.6, U2.4 (EN)
unnamed: D5.2 (A), R15.1
unnamed: D6.2 (A), R16.1
unnamed: J2.3, R4.2
unnamed: J3.3, R5.2
unnamed: J4.3, R6.2
unnamed: J5.3, R7.2
unnamed: R1.2, R2.1, R9.1
unnamed: C6.1, U4.18 (CAP)
VDD: C2.1, C3.1, C4.1, C11.1, C12.1, D1.2 (K), D2.2 (K), D3.2 (K), D4.2 (K), J6.1, R13.1, R16.2, SW3.2, U1.5 (VDDA), U1.16 (VDD), U2.1 (OUT), U2.2 (SNS), U3.3 (VCC), U4.1 (AVDD), U4.20 (DVDD)

Notes on the sheet:
CONNECTORS
MCU + STATUS
VREF
Use MCU internal pull-up
Place near STM32 VDD
Leave unpopulated on all except terminal boards (first and last)
ECE 395 FA24 - Quad Load Cell Module
POWER
FILTERS
Place around AVDD
See ADS131M0x 9.1.2
Pulldown on STB Disable standby behavior
ADDR SWITCH
CAN TRANSCEIVER
Quad Load Cell Module
2024-09-26
Place near TCAN3414 VCC
Place around DVDD
R9 is for filtering ADC negative inputs
ADC
R4-R7 are bias resistors B
TVS
Integrated pulldown Feature not used

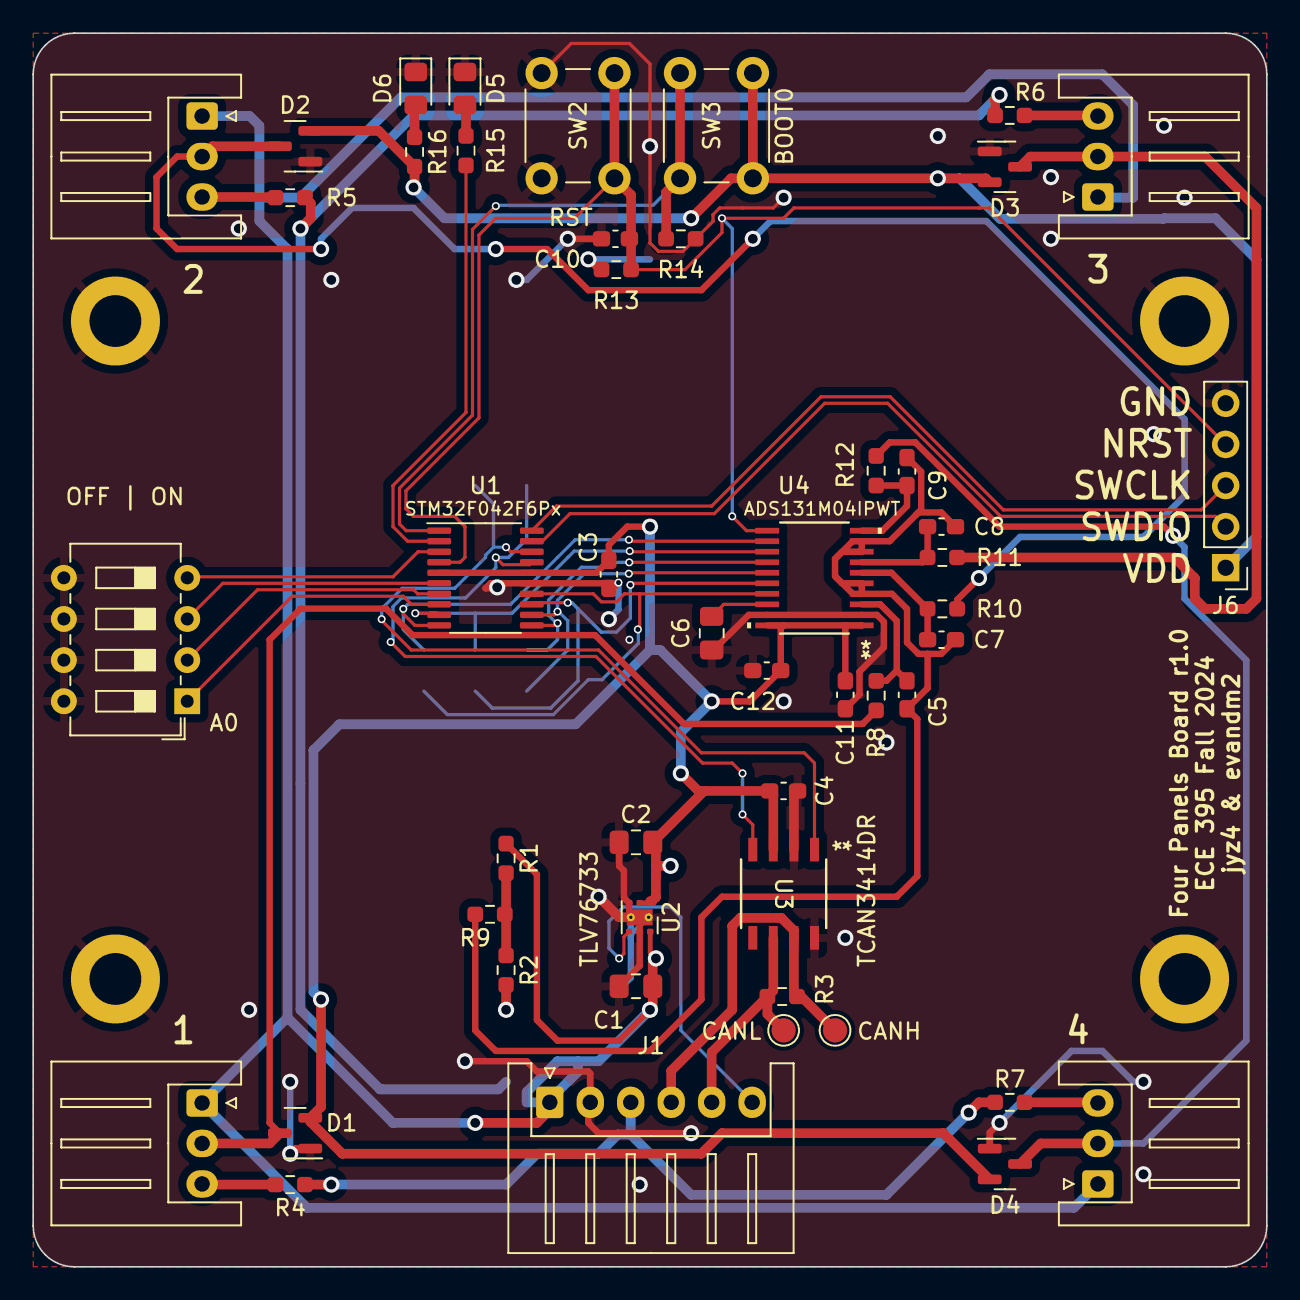
[picture p21: board corner-board-wson6.kicad_pcb from above]

Board: 2 copper layers, 76.2 x 76.2 mm, 47 parts (0 on the bottom side), 41 nets.
