lutetjeff/ece395/exercises/ex4/ex4.kicad_pcb

## KiCad design exercises/ex4/ex4.kicad_pcb (2024-10-22)

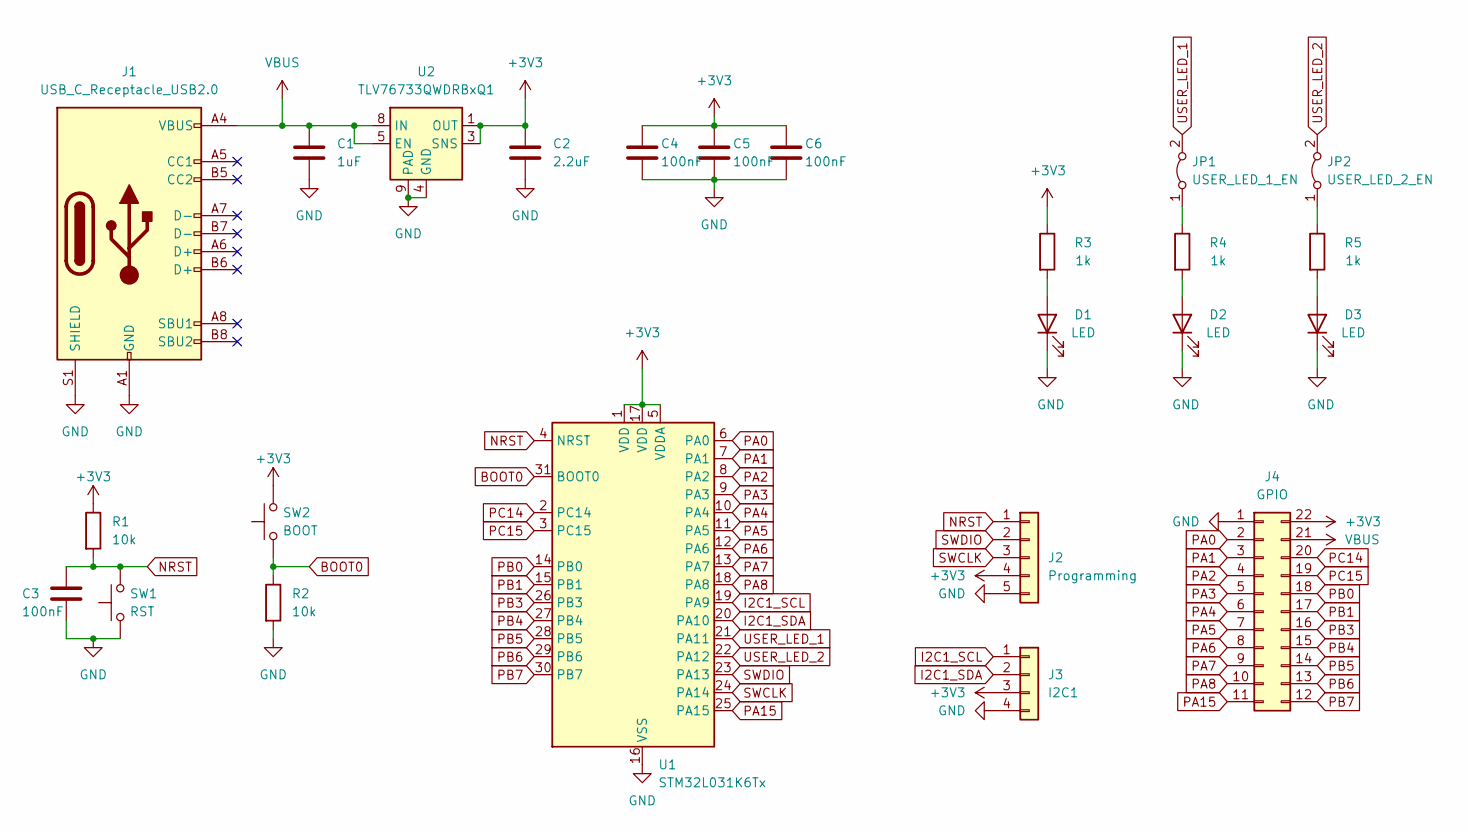
[picture p22: schematic ex4.kicad_sch]

Parts:
C1: 1uF; C_0805_2012Metric_Pad1.18x1.45mm_HandSolder
C2: 2.2uF; C_0805_2012Metric_Pad1.18x1.45mm_HandSolder
C3, C4, C5, C6: 100nF; C_0805_2012Metric_Pad1.18x1.45mm_HandSolder
D1, D2, D3: LED; LED_0805_2012Metric_Pad1.15x1.40mm_HandSolder
J1: USB_C_Receptacle_USB2.0; USB_C_Receptacle_GCT_USB4085
J2: Programming; PinHeader_1x05_P2.54mm_Vertical
J3: I2C1; PinHeader_1x04_P2.54mm_Vertical
J4: GPIO; PinHeader_2x11_P2.54mm_Vertical
JP1: USER_LED_1_EN; SolderJumper-2_P1.3mm_Bridged2Bar_RoundedPad1.0x1.5mm
JP2: USER_LED_2_EN; SolderJumper-2_P1.3mm_Bridged2Bar_RoundedPad1.0x1.5mm
R1, R2: 10k; R_0805_2012Metric_Pad1.20x1.40mm_HandSolder
R3, R4, R5: 1k; R_0805_2012Metric_Pad1.20x1.40mm_HandSolder
SW1: RST; SW_SPST_PTS810
SW2: BOOT; SW_SPST_PTS810
U1: STM32L031K6Tx; LQFP-32_7x7mm_P0.8mm
U2: TLV76733QWDRBxQ1; VSON-8-1EP_3x3mm_P0.65mm_EP1.65x2.4mm

Connections:
+3V3: C2.1, C4.1, C5.1, C6.1, J2.4, J3.3, J4.22, R1.1, R3.1, SW2.2, U1.1 (VDD), U1.5 (VDDA), U1.17 (VDD), U2.1 (OUT), U2.3 (SNS)
BOOT0: R2.1, SW2.1, U1.31 (BOOT0)
GND: C1.2, C2.2, C3.2, C4.2, C5.2, C6.2, D1.1 (K), D2.1 (K), D3.1 (K), J1.A1 (GND), J1.A12 (GND), J1.B1 (GND), J1.B12 (GND), J1.S1 (SHIELD), J2.5, J3.4, J4.1, R2.2, SW1.1, U1.16 (VSS), U1.32 (VSS), U2.4 (GND), U2.6 (GND), U2.9 (PAD)
I2C1_SCL: J3.1, U1.19 (PA9)
I2C1_SDA: J3.2, U1.20 (PA10)
NRST: C3.1, J2.1, R1.2, SW1.2, U1.4 (NRST)
unnamed: D1.2 (A), R3.2
unnamed: D2.2 (A), R4.2
unnamed: D3.2 (A), R5.2
unnamed: JP1.1 (A), R4.1
unnamed: JP2.1 (A), R5.1
PA0: J4.2, U1.6 (PA0)
PA1: J4.3, U1.7 (PA1)
PA2: J4.4, U1.8 (PA2)
PA3: J4.5, U1.9 (PA3)
PA4: J4.6, U1.10 (PA4)
PA5: J4.7, U1.11 (PA5)
PA6: J4.8, U1.12 (PA6)
PA7: J4.9, U1.13 (PA7)
PA8: J4.10, U1.18 (PA8)
PA15: J4.11, U1.25 (PA15)
PB0: J4.18, U1.14 (PB0)
PB1: J4.17, U1.15 (PB1)
PB3: J4.16, U1.26 (PB3)
PB4: J4.15, U1.27 (PB4)
PB5: J4.14, U1.28 (PB5)
PB6: J4.13, U1.29 (PB6)
PB7: J4.12, U1.30 (PB7)
PC14: J4.20, U1.2 (PC14)
PC15: J4.19, U1.3 (PC15)
SWCLK: J2.3, U1.24 (PA14)
SWDIO: J2.2, U1.23 (PA13)
USER_LED_1: JP1.2 (B), U1.21 (PA11)
USER_LED_2: JP2.2 (B), U1.22 (PA12)
VBUS: C1.1, J1.A4 (VBUS), J1.A9 (VBUS), J1.B4 (VBUS), J1.B9 (VBUS), J4.21, U2.5 (EN), U2.8 (IN)

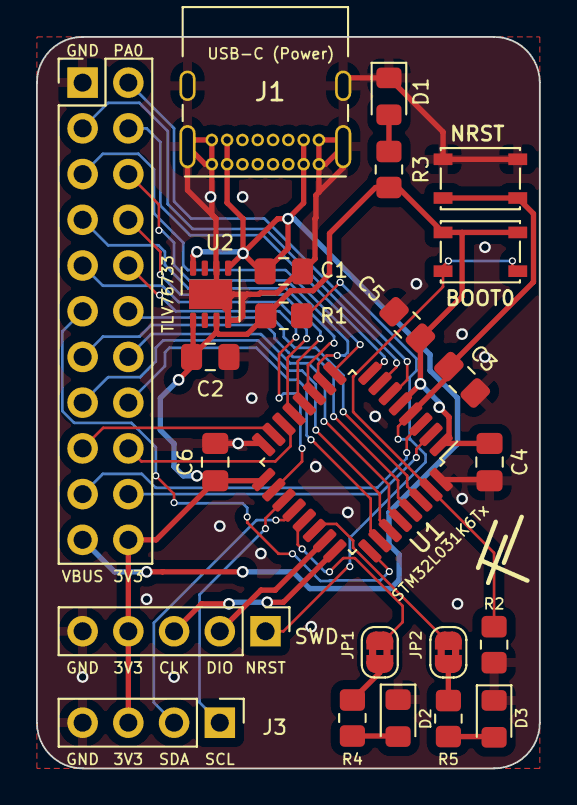
[picture p23: board ex4.kicad_pcb from above]

Board: 2 copper layers, 27.9 x 40.6 mm, 24 parts (0 on the bottom side), 35 nets.
