lutetjeff/ece395/exercises/ex3/Core/Src/main.c

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
/* Includes ------------------------------------------------------------------*/
#include "main.h"

I2C_HandleTypeDef hi2c1;

UART_HandleTypeDef hlpuart1;

void SystemClock_Config(void);
static void MX_GPIO_Init(void);
static void MX_I2C1_Init(void);
static void MX_LPUART1_UART_Init(void);
/**
  * @brief  The application entry point.
  * @retval int
  */
int main(void)
{

  /* MCU Configuration--------------------------------------------------------*/

  /* Reset of all peripherals, Initializes the Flash interface and the Systick. */
  HAL_Init();

  /* Configure the system clock */
  SystemClock_Config();

  /* Initialize all configured peripherals */
  MX_GPIO_Init();
  MX_I2C1_Init();
  MX_LPUART1_UART_Init();
  /* USER CODE BEGIN 2 */

  uint8_t data[2] = {0x02, 0x00};
  data[0] = 0x02;
  data[1] = 0x00;
  HAL_I2C_Master_Transmit(&hi2c1, 0x28<<1, &data, 2, 100);
  HAL_Delay(5);

  /* USER CODE END 2 */

  /* Infinite loop */
  /* USER CODE BEGIN WHILE */
  while (1)
  {
    /* USER CODE END WHILE */
    /* USER CODE BEGIN 3 */
    HAL_UART_Transmit(&hlpuart1, "setting led\n\r", 14, 100);
    HAL_GPIO_WritePin(LED_GPIO_Port, LED_Pin, GPIO_PIN_SET);

    for (uint8_t step = 0; step < 0x80; ++step) {
      data[0] = 0x00;
      data[1] = step;
      HAL_I2C_Master_Transmit(&hi2c1, 0x28<<1, &data, 2, 100);
      HAL_Delay(50);
    }

    HAL_UART_Transmit(&hlpuart1, "unsetting led\n\r", 16, 100);
    HAL_GPIO_WritePin(LED_GPIO_Port, LED_Pin, GPIO_PIN_RESET);

    for (uint8_t step = 0x7F; step <= 0x7F && step >= 0; --step) {
      data[0] = 0x00;
      data[1] = step;
      HAL_I2C_Master_Transmit(&hi2c1, 0x28<<1, &data, 2, 100);
      HAL_Delay(50);
    }
  }
  /* USER CODE END 3 */
}

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
