lutetjeff/ece395/exercises/ex3/ex3.ioc

Mcu.UserName=STM32L031K6Tx
PA10.Signal=I2C1_SDA
PA2.Signal=LPUART1_TX
PA3.Signal=LPUART1_RX
PA9.Signal=I2C1_SCL
PB0.GPIO_Label=LED
PB0.Signal=GPIO_Output
