lutetjeff/ece395/test-code/rhipoff-main/Core/Src/main.c

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
/* Includes ------------------------------------------------------------------*/
#include "main.h"

/* USER CODE BEGIN Includes */
#include "usbd_core.h"
#include "usbd_cdc.h"
#include "usbd_cdc_if.h"
#include "usbd_customhid.h"
#include "usbd_customhid_if.h"
#include "usbd_desc.h"
#include "usbd_composite_builder.h"
/* USER CODE END Includes */


FDCAN_HandleTypeDef hfdcan1;

PCD_HandleTypeDef hpcd_USB_DRD_FS;

/* USER CODE BEGIN PV */
uint8_t CDC_EpAdd_Inst[3] = {CDC_IN_EP, CDC_OUT_EP, CDC_CMD_EP}; 	/* CDC Endpoint Addresses array */
uint8_t CUSTOM_HID_EpAdd_Inst[2] = {CUSTOM_HID_EPIN_ADDR, CUSTOM_HID_EPOUT_ADDR};		/* HID Endpoint Address array */
USBD_HandleTypeDef hUsbDeviceFS;
uint8_t CHID_InstID = 0, CDC_InstID = 0;

FDCAN_RxHeaderTypeDef Rx_Header;
uint8_t rxData[8];
FDCAN_TxHeaderTypeDef Tx_Header;
uint8_t txData[4];
char buffer[256]; // :)
uint8_t buttons[2] = {0};
/* USER CODE END PV */

void SystemClock_Config(void);
static void MX_GPIO_Init(void);
static void MX_FDCAN1_Init(void);
/* USER CODE BEGIN PFP */
static void FDCAN_Config(void);
/* USER CODE END PFP */

/**
  * @brief  The application entry point.
  * @retval int
  */
int main(void)
{

  /* MCU Configuration--------------------------------------------------------*/

  /* Reset of all peripherals, Initializes the Flash interface and the Systick. */
  HAL_Init();

  /* Configure the system clock */
  SystemClock_Config();

  /* Initialize all configured peripherals */
  MX_GPIO_Init();
  MX_FDCAN1_Init();
  /* USER CODE BEGIN 2 */
  /* Initialize the USB Device Library */
  if(USBD_Init(&hUsbDeviceFS, &Class_Desc, 0) != USBD_OK)
  	Error_Handler();
  /* Register the CHID Class */
  CHID_InstID = hUsbDeviceFS.classId;
  if(USBD_RegisterClassComposite(&hUsbDeviceFS, USBD_CUSTOM_HID_CLASS, CLASS_TYPE_CHID, CUSTOM_HID_EpAdd_Inst) != USBD_OK)
  	Error_Handler();
    /* Register CDC Class First Instance */
  CDC_InstID = hUsbDeviceFS.classId;
  if(USBD_RegisterClassComposite(&hUsbDeviceFS, USBD_CDC_CLASS, CLASS_TYPE_CDC, CDC_EpAdd_Inst) != USBD_OK)
  	Error_Handler();
/* Store Instance Class ID */
  if (USBD_CMPSIT_SetClassID(&hUsbDeviceFS, CLASS_TYPE_CHID, 0) != 0xFF)
  {
    USBD_CUSTOM_HID_RegisterInterface(&hUsbDeviceFS, &USBD_CustomHID_template_fops);
  }
  if (USBD_CMPSIT_SetClassID(&hUsbDeviceFS, CLASS_TYPE_CDC, 0) != 0xFF)
  {
  	USBD_CDC_RegisterInterface(&hUsbDeviceFS, &USBD_CDC_Template_fops);
  }
  /* Add CHID Interface Class */
  USBD_Start(&hUsbDeviceFS);

  FDCAN_Config(); // need to set up the FD CAN peripheral with our parameters.

  /* USER CODE END 2 */

  /* Infinite loop */
  /* USER CODE BEGIN WHILE */
  while (1)
  {
  		USBD_CDC_TransmitPacket(&hUsbDeviceFS, CDC_InstID);
  		HAL_GPIO_WritePin(GPIOA, GPIO_PIN_0, GPIO_PIN_SET);
  		if (HAL_FDCAN_AddMessageToTxFifoQ(&hfdcan1, &Tx_Header, txData) != HAL_OK) // not useful rn
  		{
  			Error_Handler();
  		}
  		HAL_Delay(50);

  	    sprintf(buffer, "%d %d %d %d\r\n", rxData[0], rxData[1], rxData[2], rxData[3]);
  	    	buttons[0] = ((rxData[0] > 75) + 2*(rxData[1] > 75) + 4*(rxData[2] > 75) + 8*(rxData[3] > 75));
  	    USBD_CUSTOM_HID_SendReport(&hUsbDeviceFS, buttons, sizeof(buttons), CHID_InstID);
    /* USER CODE END WHILE */

    /* USER CODE BEGIN 3 */
  }
  /* USER CODE END 3 */
}
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
/* USER CODE BEGIN 4 */
static void FDCAN_Config(void)
{
	FDCAN_FilterTypeDef filter;

	filter.IdType = FDCAN_STANDARD_ID;
	filter.FilterIndex = 0;
	filter.FilterType = FDCAN_FILTER_RANGE;
	filter.FilterConfig = FDCAN_FILTER_TO_RXFIFO0;
	filter.FilterID1 = 0x0;
	filter.FilterID2 = 0x7FF;

	if (HAL_FDCAN_ConfigFilter(&hfdcan1, &filter) != HAL_OK)
	  {
	    Error_Handler();
	  }

	if (HAL_FDCAN_ConfigGlobalFilter(&hfdcan1, FDCAN_REJECT, FDCAN_REJECT, FDCAN_FILTER_REMOTE, FDCAN_FILTER_REMOTE) != HAL_OK)
	  {
	    Error_Handler();
	  }

	if (HAL_FDCAN_Start(&hfdcan1) != HAL_OK)
	  {
	    Error_Handler();
	  }

	  if (HAL_FDCAN_ActivateNotification(&hfdcan1, FDCAN_IT_RX_FIFO0_NEW_MESSAGE, 0) != HAL_OK)
	  {
	    Error_Handler();
	  }

	  Tx_Header.Identifier = 0x23D;
	  Tx_Header.IdType = FDCAN_STANDARD_ID;
	  Tx_Header.TxFrameType = FDCAN_DATA_FRAME;
	  Tx_Header.DataLength = FDCAN_DLC_BYTES_4;
	  Tx_Header.ErrorStateIndicator = FDCAN_ESI_ACTIVE;
	  Tx_Header.BitRateSwitch = FDCAN_BRS_OFF;
	  Tx_Header.FDFormat = FDCAN_CLASSIC_CAN;
	  Tx_Header.TxEventFifoControl = FDCAN_NO_TX_EVENTS;
	  Tx_Header.MessageMarker = 0;
}

void HAL_FDCAN_RxFifo0Callback(FDCAN_HandleTypeDef *hfdcan, uint32_t RxFifo0ITs)
{
	if (RxFifo0ITs == FDCAN_IT_RX_FIFO0_NEW_MESSAGE) // we have a new message!
	{
		if (HAL_FDCAN_GetRxMessage(&hfdcan1, FDCAN_RX_FIFO0, &Rx_Header, rxData) != HAL_OK)
		{
			Error_Handler();
		}
	}
}


/* USER CODE END 4 */
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
