lutetjeff/ece395/test-code/corner-board-code/Core/Inc/main.h

#define LED_Pin GPIO_PIN_0
#define LED_GPIO_Port GPIOF
#define A3_Pin GPIO_PIN_1
#define A3_GPIO_Port GPIOF
#define A2_Pin GPIO_PIN_0
#define A2_GPIO_Port GPIOA
#define A1_Pin GPIO_PIN_1
#define A1_GPIO_Port GPIOA
#define A0_Pin GPIO_PIN_2
#define A0_GPIO_Port GPIOA
#define DRDY_Pin GPIO_PIN_3
#define DRDY_GPIO_Port GPIOA
#define DRDY_EXTI_IRQn EXTI2_3_IRQn
#define CS_Pin GPIO_PIN_4
#define CS_GPIO_Port GPIOA
#define CLKOUT_Pin GPIO_PIN_1
#define CLKOUT_GPIO_Port GPIOB
