lutetjeff/ece395/(commit log)

2024-10-30 add drdy interrupt
2024-11-11 can fix, 38.8% bus load lolw
    [corner-board-code.ioc, main.c]
2024-11-19 CAN it? It CAN!
    Began work on the CAN protocol for main board and getting data out to USB CDC
2024-12-06 Attempting to implement CustomHID class
    Got most of the way there (I think) and did a bilinear interpolation exercise that didn't prove helpful...we have four data points after all. Different method should likely be used if any
    [main.c, main.h]
2024-12-09 HID kind of functional
    Gamepad works, but I can't get HID & CDC to cooperate together...yet. Something about the composite building is causing problems.
    [main.c, main.h]
2024-12-14 Likely final commit
    Added main board KiCad files to repo and reorganized a bit
    [395MainBoard-B_Cu.gbr, 395MainBoard-B_Mask.gbr, 395MainBoard-B_Paste.gbr, 395MainBoard-B_Silkscreen.gbr, 395MainBoard-Edge_Cuts.gbr, 395MainBoard-F_Cu.gbr, 395MainBoard-F_Mask.gbr, 395MainBoard-F_Paste.gbr]
2024-12-14 Added CAD files
    Prototype CAD files & drawings now included in repository for reproduction.
    [Generic Single Pad Assembly v8.f3z, Load Cell Mount v8.f3z, Plunger v1.f3d, Polycarbonate Top v1.f3d, SparkFun Generic Load Cell v1.f3d, Wooden Base v4.f3d]
