lutetjeff/ece395/(notices)

Notices in the files:
exercises/ex3/Core/Src/main.c:
Copyright (c) 2024 STMicroelectronics.
All rights reserved.
This software is licensed under terms that can be found in the LICENSE file
